Jurriz/VHF-Unit/README.md

# VHF-Unit
### Examensarbete Josef Lundberg, utfört åt followit.

Följande dokument är en projektplan för kursen X7006E, Examensarbete i Teknisk Fysik och Elektroteknik, Elektroteknik, Civilingenjör vid Luleå Tekniska Universitet. Arbetet kommer pågå i 20 veckor mellan januari till juni 2018. Målet är att ta fram en layout för ett kretskort på en ny produkt åt företaget Followit. Arbetet utförs av studenten Josef Lundberg. 

- Bakgrund: 

Företaget arbetar med trådlös kommunikation i form av olika former av spårningsutrustning. De använder olika typer av kommunikation däribland GPS, radio och GSM – teknik. Företaget håller på att utveckla en ny produkt som skall kommunicera med VHF teknik, vilket är samma frekvens som använd i radioapparater och till vissa Tv-kanaler. Denna typ av teknik använder redan företaget i andra produkter. Till denna produkt behöver företaget utveckla ett nytt kretskort, vilket detta projektarbete kommer handla om.  

- Utförande:  

Arbetet kommer handla om att ta fram en layout för detta system för en framtida produktion. Till projektet har företaget tagit fram de komponenter och delar som skall finnas med på kortet. Vikten kommer ligga på att genom noggranna studier kring kretskortstillverkning och i detta fall högfrekventa signaler på kortet göra ett kretskort som både fungerar som de skall och där inga störningar eller brus hämmar systemets funktion. Kretskortet kommer att vara mycket litet och strömsnålt. Nugranna studier skall göras innan för att på så sätt skapa en förståelse för den kod som skall köras på processorn och vidare kunna verifiera att alla delar och komponenter på kortet fungerar som tänkt. Varje komponent finns redan som utvecklingskort. Dessa kan inviduellt testas och verifieras med hjälp av en enklare typ av microkontrollen, typiskt en Arduino. 

Efter tillverkning skall kortet testas utförligt för att försäkra dess funktion. Vidare om tid finns kan en inkapsling till det kompletta systemet modelleras.

Detta examensarbete kommer att bidra till en större förståelse kring utformningen och designprocessen vid tillverkningen av ett integrerat system på ett kretskort. Samt att företaget i fråga kommer att få ett färdigt förslag på en layout som de sedan kan använda i sin produkt.  

Länk till min dagbok och all nyttig data på [OneNote!](https://onedrive.live.com/edit.aspx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)

#### En grov tidsplan över arbetet:
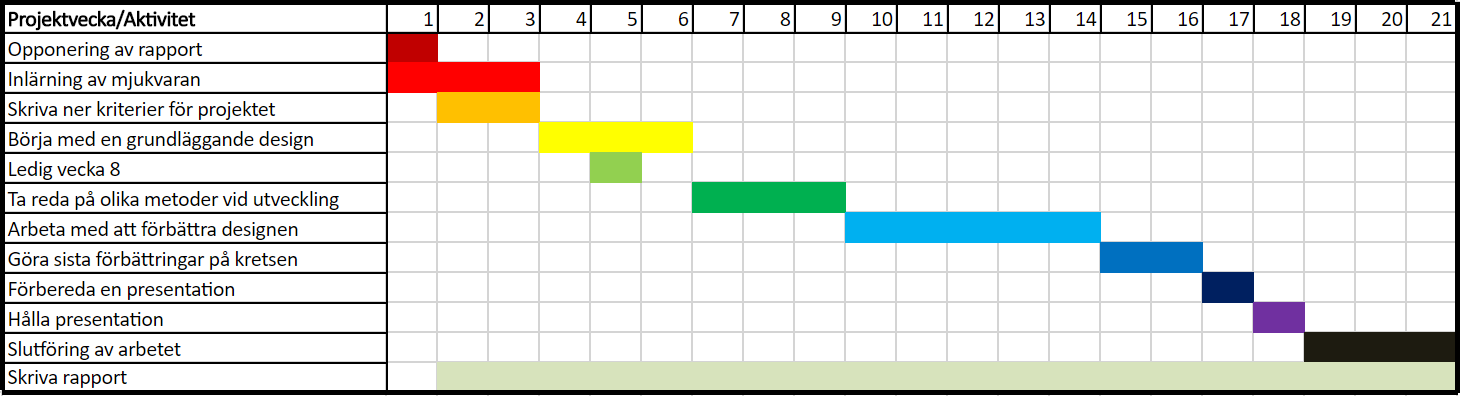
[picture p1: Tidsplan.png]
Tidsplan Josef
