Jurriz/VHF-Unit/Report/Gamla filer/Report LAtaex/Schematic.tex

\vspace{-10ex}%
\rule{\textwidth}{0.3pt}
\vspace{5ex}

To the \gls{pcb} a schematic over the complete system has to be constructed. This is built by noting all the connections that were determined in earlier chapter. The complete system is split up in to two different schematics, one describing the Radio components and the other shows the processor and all the other parts.
