Jurriz/VHF-Unit/Report/Gamla filer/Report LAtaex/method.tex

Hej detta är första dfelan av metoden

\section{schematics}
The idea that was presented to me was a half finished principle that i needed to understand and also expand with all the neccesary components that is not mentioned in this design.
