Jurriz/VHF-Unit/Report/main.pdf

Lule˚a University of Technology

Dept. of Computer Science, Electrical and

Space Engineering

# Master Thesis Engineering Physics and Electrical Engineering VHF-Unit

June 1, 2018

# Abstract

Surveillance and control have come a long way in the last years. Every new mobile phone, most cars, and smart watches have a Global Positioning System (GPS) tracing device built into it. Today it is hard to go anywhere without there being some sort of way of finding you. The art of finding has been around for a long time and one company that have taken the tracking aspect to the next step is Followit. For over 40 years they have built different types of satellite and radio transmitters to keep track of everything from small animals like hares and dogs to big elephants. They also got tracking solutions for vehicles like trucks and excavators.

i

# Preface

I would like to thank all the personal at Followit for taking me in and helping me through the project time. A special thanks to Bengt Evertsson for his help and all the good tips throughout the board layout development.
A big thanks goes to my supervisor Jonny Johansson at LTU for his support and guidance in the project.

Josef Lundberg
Lindesberg, June 1, 2018

ii

# Contents

Abbrevations | v
1 Introduction | 1
2 Theory | 5
3 Hardware | 9

iii

4 Software | 16
5 Results | 18
6 Schematics | 21
7 Discussion | 22
Appendices | 25
.2.1 | Bill of Materials: Main Printed Circuit Board (PCB) . . . | 27

iv

# Abbrevations

CAD Computer-aided design (CAD) is a computer system which aids the creation and modification of some kind of design. 15,

CLE CLass E (CLE, is a highly efficient switching amplifier type. 6

GPS The Global Positioning System (GPS) is a radionavigation system owned by the United States government and operated by the United States Air Force. It uses sattelites for geolocation and time. i

I

2C Inter-Integrated Circuit (I²C), is a serial computer bus. 3, 8

IC Integrated Circuit (IC) is a set of electronic circuits on one small flat chip. 1, 6, 7, 14

IMU Inertial Measurement Units (IMUs) are integrated circuits that can measure acceleration, rotational velocity and magnetic field strength. 10, 13

JTAG JTAG is an industry standard for verifying designs and testing printed circuit boards after manufacture. 16

LDO A low-dropout regulator is a DC linear voltage regulator that can regulate the output voltage even when the supply voltage is very close to the output voltage. 10, 19

LED A Light-emitting diode (LED), is a two-lead semiconductor light source. 3

MCU A Microcontroller Unit (MCU) is a single computer chip designed for embedded applications. 2, 7, 8, 10–12, 16, 20

PC Personal Computer (PC) is a multi-purpose computer whose size, capabilities, and price make it feasible for individual use. 20

PCB A Printed Circuit Board (PCB) is the common acronym when referring to populated circuit boards. iv, 1–3, 5, 6, 9, 15, 16, 21, 27

RF Radio Frequencies (RF) 6

v

RTC A Real time clock is an IC that is used to mesure time even when the main device is off. 10

SPI Serial Peripheral Interface 3, 7, 17, 20

ST STMicroelectronics 13, 23

TCXO Temperature Controlled Crystal Oscillator is an precise type of clock source which compensates for temperature differances. 12

TI Texas Instruments Inc. (TI) is an American technology company that designs and manufactures semiconductors and various integrated circuits. 23

UART Universal asynchronous receiver-transmitter 19, 20

VHF Very High Frequency (VHF) is the frequency band spanning all the frequencies from 30 to 300Mhz. 2, 14

VIA vertical interconnect access 9

vi

1

# Introduction

This chapter describes the idea behind and the background to this project. A rough sketch of how the work is divided and the goals for this project is provided.

## 1.1 Background

This is not a new area of products for Followit, different types of radio sending units have been made for over four decades now. With new and improved technology arriving each and every year new products ought to be made to have the latest most efficient and effective systems. Every generation of a component will most likely have a smaller physical size, have more advanced features and draw less power than the previous one. Followit wants to make a new unit which implements all the new and improved technologies into a small, advanced product with low power consumption. Customers have been asking for a simple, small and cheap radio unit from the company to complement their more advanced and powerful products. With this type of product, they could produce them in a larger number and gain new sale territories. By having such a small product it can be used in new areas that they never could before. The smaller the animal you want to track, the smaller equipment you could strap to them. This is one of the reasons that this product is so sought for in the business.
Most of the Integrated Circuit (IC)’s are already chosen by the company, but there are no actual implementations. The final version is supposed to work in different areas, both as a tracker for animals and also as a product for theft protection in cars and vehicles. This means that the design of the product needs versatility to work in all these different areas. Much consideration is taken to get the product both small and inexpensive. The cost of the PCB depends on the size, manufacturing and the numbers of layers. The rest of the cost comes down to the components, batteries, and casing.

1

Project VHF-Unit | June 1, 2018

## 1.2 Project goals

Followit wants to produce a Very High Frequency(VHF) radio unit which has a powerful Microcontroller Unit (MCU) for advanced programs and with some extra features that make it possible to use the finished product in different areas and with different types of characteristics. The project involves a first test prototype and a final version which is presented to the company as a finalized product ready for marketing and sales. To ensure proper functionality of the prototype a test program is written to the system to test the connection and functionality of all the components and accessibilities.
Both the cost of the bare board and the components need to be kept down. This requires some special attention to the board design, the manufacturing and component selection. There will be a study of the ways of making the product both small and cheap at the same time. The problem formulation will be considering making a prototype which is tiny but has a high manufacturing cost and an inexpensive that have a bigger physical size. The procedure of finding a good balance between the two is explained later in further detail.

## 1.3 Scope

The main focus of this thesis is to create a PCB prototype that is tested and well designed and works as intended. Some of the components in the product are predefined but their implementation has to be done. Extended test code is written to the product which includes tests for all the components in the circuit. The final PCB design will be delivered to the company for further programming and implementation. In case of time, a casing for the product as well as battery considerations will be made.

2 of 28

Project VHF-Unit | June 1, 2018

## 1.4 Approach

The idea that was presented to me was a half-finished principle that I needed to understand and also expand with all the necessary components that are not mentioned in this design. The initial work prior to this project can be seen in Figure 1. To get an understanding of all the parts and what there function are, a list is constructed for a simple overview of the system.

- MCU - For processing data and connecting all the periferals together to a complete system.
- Accelerometer - Used for measuring movements. Important for knowing how much the device is moving or if lying still.
- Radio - All the communication to and from the outside world is done using radio transmissions.
- RF switch - To switch between two low pass filter antennas from a single output.
- Real time Clock - The best way to keep an exact time, used for the system to keep track of the time even after one year of constant operation.
- Hall switch - To turn on and off the device, a solution that is already used by the company.
- Programmable buck converter - To alternate the supply voltage for the system.
- Logical inverter - To invert the signal for the programmable buck converter.
- LDO - Supply the radio oscillator.
- Miscellaneous components - Two Light-emitting diode (LED)’s, two oscillators, one for the processor and one for the radio module.

To get to the point of making the actual PCB a thorough analysis of the components and their connections need to be made. Firstly the datasheets are considered for an understanding of the component itself and the required connections for this particular implementation. Both power and data are crucial for operation and there might also be some peripherals connections and chip selection that needs to be considered.
By writing a program the functions of each individual component can be tested. The processor used in this project comes from the PIC18 family of 8-bit processors produced by Microchip Technologies. This processor is a fairly simple unit, which makes it a bit more challenging to program. It doesn’t have
a bunch of advanced libraries for example communication through Serial Peripheral Interface (SPI) or Inter-Integrated Circuit (I²C) like some other commonly used processors. The process will, therefore, involve some close to hardware programming. A more thorough description of the processor will be described later in this report. The code language used for this project is C.

## 1.5 Ethical and useability aspects

When designing a system meant for tracking and survaillence, one can think of the aspects of this. Tracking animals can be used by both the agricultuar and animal rising aswell as studies and wild animals. The radio unit can also

3 of 28

Project VHF-Unit | June 1, 2018

be attached to veichles or equipment. One aspect of a radio tracking device is that no special equipment or extra security is considered. If someone wants to track down the radio unit one can do so without problem, there is only the matter of finding the sending frequency and start searching. The unit is constructed for easy useabillity, with almost no ways of interagate with the product. Without buttons, interface or cables it is set up initially at the company to match all the customers criterias, scheme and functions directly out of the box. The only way of trancieving data to the unit is with the use of the radio. This is to possibly change the scheme, function and settings. This function is implemented in the hardware but possibly not used for this product until later in it’s lifecycle when the function is considered to be useful.

4 of 28

2

# Theory

This chapter will introduce the reader to the problem formulation and the underlying principles taken into account. The principle of radio communication and the important steps involved in developing a new product prototype will be presented. Basic information about the communication and programming will also be presented.

## 2.1 PCB

Good characteristics of the circuit the system will be produced on a four-layer PCB. This has a lot of advantages over a standard two-layer board. The four-layer design will have a top layer where all the components will be placed, a bottom layer with extra room for tracing tracks and having another ground polygon. The two inner layers consist of a power plane and a ground layer. Benefits of this are both easier connectability and also as a good way of making the circuit more resistant to high-frequency noise between the traces on the top and bottom layer.

## 2.2 Radio Frequency

Radio frequencies are a set of frequencies that are used for transceiving and receiving data wirelessly. Radio frequencies begin at one end of the spectrum where the frequencies are about 100Hz. It contains all the frequencies up to 300Ghz. Radio frequencies are divided into different bands, all with different characteristics and areas of implementation. A frequency spectrum is provided in Figure 2.1.

5

Project VHF-Unit | June 1, 2018

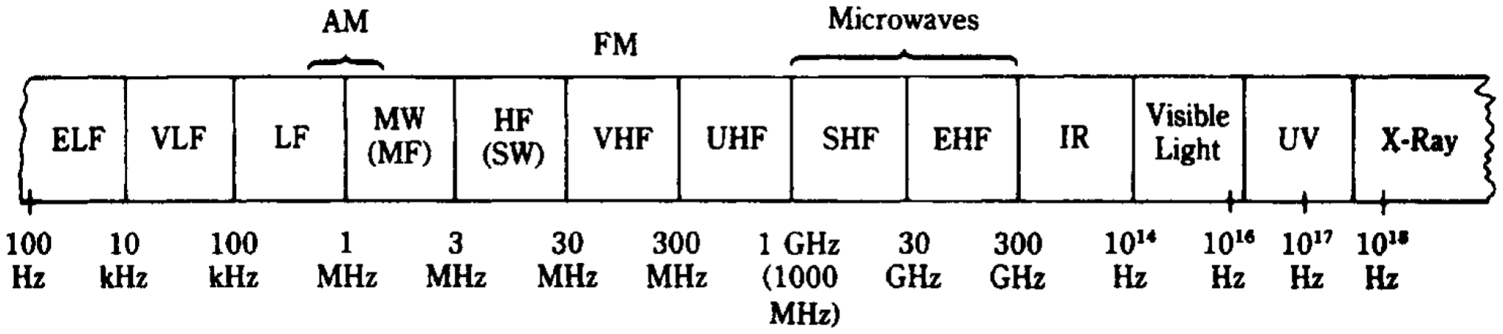
[picture p9: figure]

Figure 2.1: Electromagnitical frequencies Source: RF Circuit Design [? ]

## 2.3 Problems

Designing a circuit for radio transmission is an advanced and complex procedure. The high frequencies introduce a lot of interesting phenomena that need to be considered when constructing a circuit in these frequencies. When designing a circuit for Radio Frequencies (RF), components and traces on the PCB behaves in a different way and takes on different characteristics than an equal system at lower frequencies. Some of the challenges that arise are described in Secrets of RF Circuit Design [12]. Stray capacitance is one of the phenomena that arise when handling RF. Between conductors, conductors to ground and between components a small capacitance occurs when dealing with RF.
Another phenomenon that introduces is the so-called skin effect, where the ”skin” part comes from the physical phenomena that are happening. When the frequencies rise the resistance in a conductors core increases with it. As current choose the path of least resistance and will therefore in higher frequencies flow only on the outside most part of a component. A visual explanation of this can be seen in ??.
The output signal from the radio transceiver is matched at 50 ohms and this has to be matched with the output stage components. These components commonly is a network of inductors and capacitors. This matching network is described later in this section. From different types of radio signal transceiver, the type used in this case is determined by the radio IC’s manufacturer. [4]

### 2.3.1 Class E amplifier

The CLass E (CLE) amplifier type used here uses switching type of amplification to increase efficiency and reduce power loss. The most interesting part of CLE is the fact that up to ideal power efficiency can be achieved by constructing this type. [15]

### 2.3.2 Chebychev Filter

The Chebyshev type of filter is special in the fact that it has a steep fall rate and a high Q. The Q factor is commonly used in filter design as a function of the length of the stopband through the whole passband. This makes it very suited for radio designs.

6 of 28

Project VHF-Unit | June 1, 2018

### 2.3.3 Radio antenna filter

Stating in the datasheet to the radio IC the rough design aspects are defined. The Chebyshev filter is recommended for this radio for its good characteristics. With a high Q value the steeper the slope is in the stop-band region.

## 2.4 SPI

SPI communication is used to communicate between the MCU and other IC’s on a circuit board.SPI uses four wires to communicate and additional one wire for each extra IC that is connected. The transmission works in a synchronous serial manner where each bit is sent one at the time synchronous to a supplied clock signal. Different types of SPI connections exist but with the most common being the four-wire serial bus. Here SCL, SDO, SDI, and SS is used. [2]

- SCL - Serial CLock, a clock is supplied to synchronize the data transmissions.
- SDO - Serial Data Out, Data is sent from this port.
- SDI - Serial Data In, Data is transmitted to this port.
- SS - Slave Select, Selects a device for communication.

Eight bits are sent together to form a package of one byte. Four different modes are available when communicating through SPI. These modes determine which type of clock signal provided and how the data is sampled in the devices. Two different types of clock-signal, one where the clock is pulled high when idle and the other one pulled low when idle. This is often called in the registers as; CPOL. The other mode selects the timing of data bits relative to the clock signal. Data is sampled either when the clock signal goes high or in the middle of a clock pulse. CPHA is the often the name of this selection. This concludes the different modes. A visual explanation of SPI communication is provided in Figure 2.2.

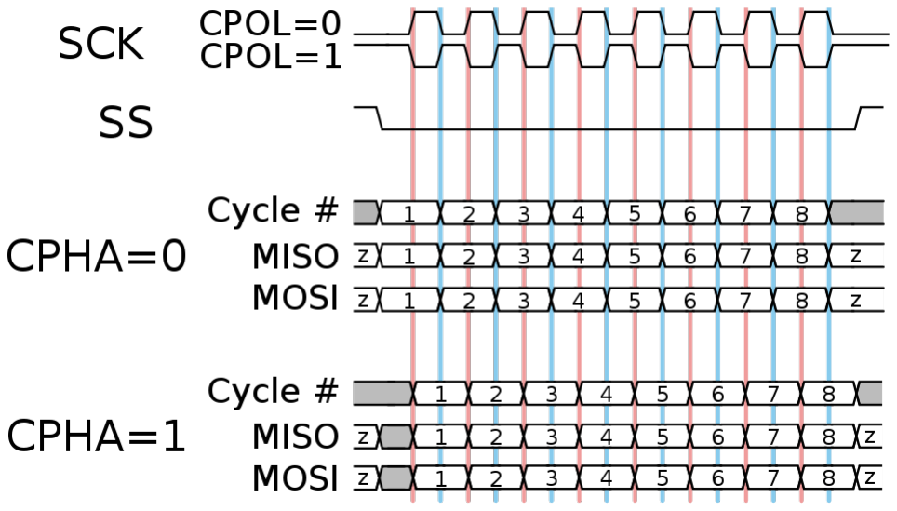
[picture p10: figure]

Figure 2.2: Timing and modes for a transmission over SPI Source:
https://commons.wikimedia.org/wiki/File:SPI_timing_diagram.svg

7 of 28

Project VHF-Unit | June 1, 2018

The interface uses one master device and multiple slaves. The master device handles the communication and supplies the selection of slaves. To enable a connection and choose which slave is used an individual slave select must be present. When set, only the chosen slave device is able to communicate. From the MCU’s datasheet the following diagram show in Figure 2.3 how the connection works when connection several slave devices.

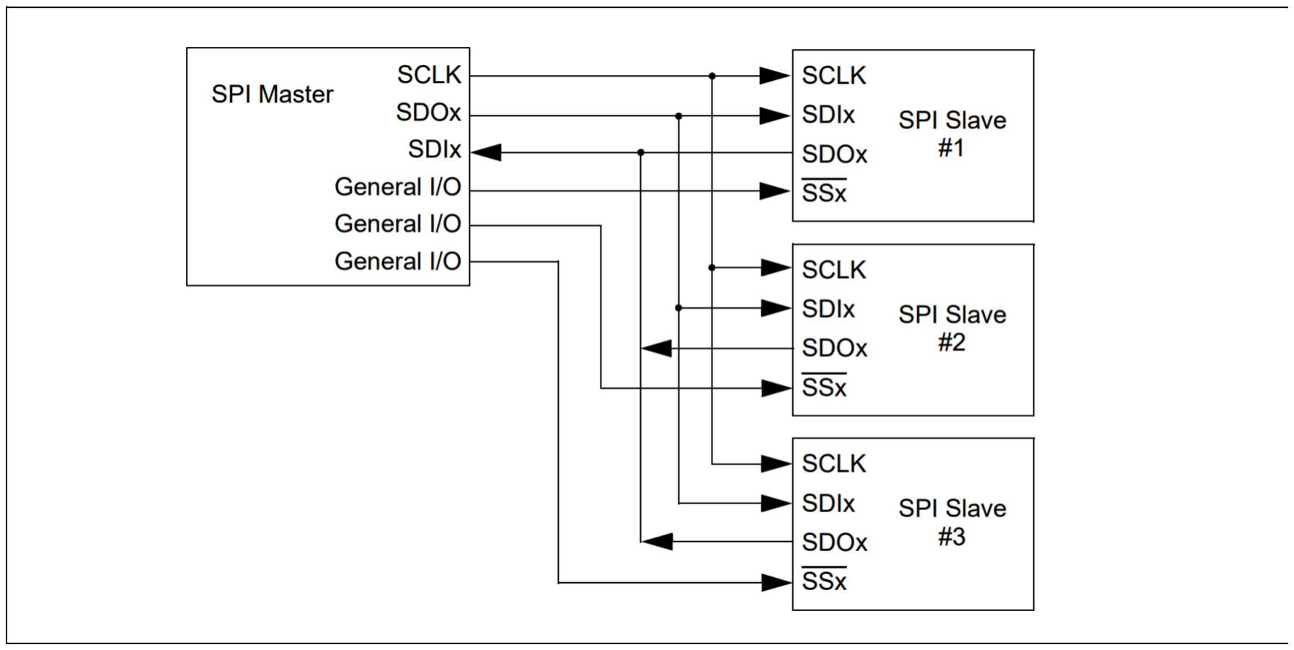
[picture p11: figure]

Figure 2.3: SPI master and multiple slave connections Source:
http://ww1.microchip.com/downloads/en/DeviceDoc/40001412G.pdf

Data is sent out from the MCU at the SDO wire and at the other end connected to the SDI pin of a receiving device.

## 2.5 I

2C

A more advanced type of communication is I

2C. I

2C is more often used in
larger circuits or when the distances are longer. The I

2C interface uses pullup resistors to set the idle state of the signals high. Different speeds require different types of resistors, with the higher resistors not able to handle faster transfer speeds but draw less power when transmitting data.

8 of 28

3

# Hardware

From the objects described briefly in earlier chapters a complete system is constructed. A deeper look into each component with some information of their functionality and implementation will be presented in this chapter. Why some specific components are chosen is also answered here.

## 3.1 Layout parameters

When starting the layout some initial rules need to be set up. These parameters are set by the board manufacturer. The design can be produced at different places but when ordering from this manufacturer the constraints that are used is the same parameters that the supplier uses as their standard. These rules and constraints may differ from one supplier to another but as the company already uses this supplier the same will be used for this project. Naturally, for this project, the minimum spaces and distances that does not make for a supplement charge are chosen as the design rules. A list of these parameters can be seen below.

- Trace width: minimum of 6 mils (0,1524mm)
- Vertical Interconnect Access diameter: 10 mils
- Maximium thickness of board

### 3.1.1 Landgrid

Each component on a PCB have their own landgrid design, which corresponds to the components contact pads. These pads are copper pads on the PCB which is left open and separated from the solder resist material covering the rest of the PCB to hold the component and the solder. Often are the pads a bit larger then the acctual contact point of the component to accomendate some additional solder and making the soldering process as easy and troublefree as possible. One simple landgrid design used in this report is the 0402 package size for passive components, the design can be seen in ??.

9

Project VHF-Unit | June 1, 2018

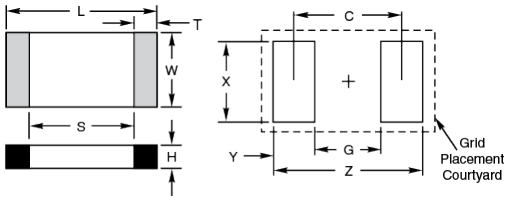
[picture p12: figure]

Figure 3.1: The prototype connection Source: Aurthor

Some of the design aspects used are described earlier and here they will be described in more detail. The industry standard is always good to aim for, in this case, the basic designs are taken from IPC’s design guidline[? ]. While these are made for optimal manufacturability the footprints used on the test board are modified to enable for easier solderability, production and rework if needed. The landgrids are made slightly bigger and longer to achieve this. The downside of making the pads larger is that each component takes up more real estate and the final board size increases.

### 3.1.2 Easy prototyping

The components that are going to be used in high frequency often come in tiny packages. The best components used in this area of work will be small to fit in small modern advanced systems like mobilephones and. This gives the protypability problems with easy ability to solder and use, To make a

## 3.2 Structure

The product is constructed with a number of components, which all have a central role in the final product. They can all be seen in Figure 3.2. A list of the major components and their function can be seen below:

- MCU: The central part of an integrated system, handles all the calculations and the program code.
- Radio: All the communications with the rest of the world will be handled by the radio, sending on the VHF and UHF band.
- Inertial Measurement Unit (IMU): Movement detection is measured with an accelerometer, this to determine if the unit is in motion or lying still.
- Low-dropout regulator (LDO): A Low-dropout regulator can supply the system with a smoother voltage because no switching is taking place.
- Hall sensor: The hall sensor is used as a switch for the system by sensing if a magnet is nearby and then turning off the circuit.
- Real time clock (RTC): A real-time clock is important to acquire data at a specific set time. It is important that the clock is exact over the whole life of the product.

10 of 28

Project VHF-Unit | June 1, 2018

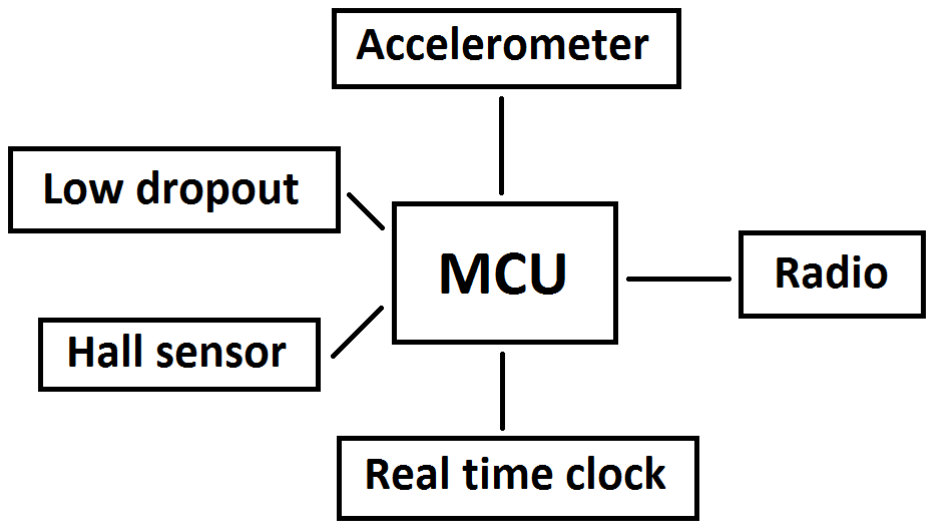
[picture p13: figure]

Figure 3.2: The prototype connection Source: Aurthor

Each of the components of this project is carefully chosen to get the functionality and effect that the company is after. To ensure the system works as intended the company has acquired development boards to each of the components. Every component needs to be tested to ensure their individual functionality. Each development board is connected to the microcontrollers board. First off, the MCU have to be set up in a correct way with all its parameters and then the other components could be connected and initialized one after another. The whole connection can be seen.

## 3.3 Micro Controller Unit

Every advanced system needs a central processing unit to make all the calculations needed. Why a lot of systems needs some powerful processor this system wich is a bit easier with The power consumption is higly dependent on the speed of which the processor is runnig, the faster the more power it consumes and also the slower the less current it will draw. And by the MCU beeing the component with the single higest power consumption the speed is set to a speed as low as possible. This low speed is not a concern in this particular system when the operations required is not time or speed sensitive. The voltage supplied to the MCU is another parameter that will alter the power consumption. The comonent is a low power model which can handle a lower source voltage. A voltage between 1.7 to 3.6 is required, anything lower will not start the device and anything higer will damage the the part. To get the right speed of a crystal we need to get the right product for this particular case. Many different types of oscillators exists, both internal and external types. The MCU used for this project is a processor type that is used by this company many times before and has been chosen to this project for its small size, low power draw, sufficient connections, and features. The particular processor used is the PIC18LF46K22[3]. The version used is one with 40 pins. All the connections available are shown in Figure 3.3.

11 of 28

Project VHF-Unit | June 1, 2018


Figure 3.3: PIC18LF46K22 pinout Source:
http://ww1.microchip.com/downloads/en/DeviceDoc/40001412G.pdf

### 3.3.1 Power

Powering it is done by connecting the VDD pins to the power net. Connected to the ground is the Vss pins on the processor. To ensure the current fed is as smooth as possible capacitors are connected between these two pins. The value of these capacitors is chosen to 100nF.

### 3.3.2 Oscillator

To operate the MCU a clock signal is mandatory, this can be implemented in different ways. Either with the internal High, Medium and Low-frequency oscillator or an external one. Where the external rely on a specific circuitry to provide the clock source. Examples of external oscillators are clock modules, quartz crystal resonators or ceramic resonators and resistor-capacitor circuits. When a circuit is specified to be power efficient the speed of the clock plays a central role. As this product is specified to run on a small battery the speed of the system is kept low to increase the lifetime of the battery. The clock signal is generated from an external Temperature Controlled Crystal Oscillator (TCXO).

## 3.4 IMU

12 of 28

Project VHF-Unit | June 1, 2018

## 3.5 Accelerometer

The motions of the system are measured with an IMU system. This system can be used in a lot of different cases, both to detect if the unit is stationary or moving or if there are very hard and fast movements in the product. One of the simplest IMU’s is the 3-axis accelerometer, it detects accelerations in three axes, x, y, and z. The component used is a 3-axis, ultra-low-power and high-performance accelerometer from STMicroelectronics (ST) [5]. The component is the simplest of IMU’s that this manufacturer has and this simplicity makes for a product that is only incorporate one single function. 3-axis accelerometer means that it can measure

### 3.5.1 Power

Two voltage connections are apparent on this device, one which is called VDD and the other is called VDD-IO. The VDD is the supply voltage and VDD-IO determines the logic voltage level.

### 3.5.2 Connenctions

13 of 28

Project VHF-Unit | June 1, 2018

## 3.6 Radio component

The radio module used in this project is from the company Silabs. The chosen radio IC have the characteristics that are wanted in this type of product. The radio transmission used is the earlier explained class E. With this pice the class E is already implemented in the radio as this is widely used today and a very effective radio signal. The type of filter used for sending radio signals at VHF frequencies is defined in the defined

### 3.6.1 Power

### 3.6.2 Connenctions

In the registers

14 of 28

Project VHF-Unit | June 1, 2018

### 3.6.3 Solidworks PCB

Followit uses the PCB board design software Solidworks PCB from DAS-SAULT SYSTEMES. It utilizes the industry-proven Altium design engine ` for layout and routing of printed circuit boards and combined with a close connection with the mechanical Computer-aided design (CAD) of classical Solidworks. With this program, the PCB layout and design can be transferred seamlessly over to the mechanical environment to create an exact case or enclosure for the circuit board. The version used in this thesis is (Update 2.0).

## 3.7 Power consumption

The total power consumption is calculated by adding the current draw from each individual component together. A different test is conducted to try different modes of the system. One describing the power consumption of only the processor. This is done by running it in an infinite loop with all the other components at the circuit powered down or in power down mode. Since the system is not supposed to be active just a small time with a longer power down mode in between the power consumption on the system has to account for a longer time span. The tests are made with a standard scheme used already by the company. The scheme consists of a small radio pulse every second and the system being inactive in between these radio pulses.

15 of 28

4

# Software

What is the step after the PCB is produced? It is time to test the system, and this is done with the help of a test program. This chapter will guide the reader through this process of setting up the processor to run program code. How all the components are programmed and tested will be explained in this chapter.

## 4.1 Programming

In the start of every embedded system, the processor have to be programmed. Here the most common implementation is the Joint Test Action Group (JTAG), where the all the programming and debugging is done through a standardized interface. The approach is different on this MCU, here three pins are used
to program the device. The first one is the ”PGC”, which is the clock signal for the In-Circuit Debugger and ”PGD”, In-Circuit Serial Programming. The third pin needed from the processor is the MCLR. These pins on the processor have to be accessible to program the microcontroller.

## 4.2 Software implementation

The processor does not start up on it own, much consideration needs in making right initialization and configure it right. A source voltage is supplied to the processor to get it to operate. There are some initial registers that need to be set in order to initialize and start the processor. This varies between different processors and models and is different for applications and systems. These registers contain information about the speed of the processor.

## 4.3 Radio implementation

Radio Chip Waking Up First, the radio is in the off state. After the SDN pulled low, wakes up and performs a Power on. maximum of 6 ms (900 µ s room temperature) ready to receive commands on the SPI bus. The GPIO1 pin goes high when the radio is ready for receiving SPI commands. During the reset period, the radio cannot accept any SPI commands.

16

Project VHF-Unit | June 1, 2018

### 4.3.1 Accelerometer implementation

The accelerometer communicates with SPI, this requires three wires that has to be considered in the code.

## 4.4 PC software

The foundation for every development is a good development environment, both as the circuit boards are created and the software implementations needed later in the process.

### 4.4.1 MPLAB

Microchip which is the producer of the MCU used in this project has their own development environment which holds a lot of handy features when making a program for their products.

### 4.4.2 Assembly

The actual code that runs on this processor is assembly, the most common hardware code which is used in almost all types of MicroController units. Assembly is a hardware type language which means that describes the actual process for the In the early days of computing, programming in Assembler was used to program almost any type of computer. These days, however, it is pretty much the preserve of embedded designers, particularly when using smaller 8-bit devices. [16]

### 4.4.3 C18

The C program is compiled with the compiler C18. This is the compiler which has been the official compiler for this particular processor. This compiler is used for all the processors in the family PIC18. This compiler is some years old and lacks some modern features. The version used in this project is (3.47)?

17 of 28

5

# Results

This chapter will guide the reader through the whole process of developing a system prototype. Designing the PCB, soldering the components, troubleshooting the board and writing the necessary code are some of the steps involved and they will all be described in detail here.

## 5.1 Schematics

The schematics over the circuit is created by placing all the components discussed earlier, every IC have a small number of components that are placed in a way so that it is easy to understand which components belong to which. A title is added to every part in the design for a good overview of the system. Since the section which included the radio is large it is placed on a separate page. When additional components are added in additional pages can be inserted. These schematics can be found in ??.

## 5.2 Layout

### 5.2.1 First design

The first of two boards is 3.5 times 3.5 mm in size. The different parts of the circuit are laid out in a way that it is easy to inspect and resolder if necessary. The main components of the board are placed close to each other at one side to get an idea of the design for the final product. This board is equipped with some test points for easy connections with test probes and oscilloscope. The silkscreen print on the top of the board was vague at some places and made distinguish them from each other hard. The pin one location at one part could not be spotted. A view of the board can be seen in ??.

18

Project VHF-Unit | June 1, 2018

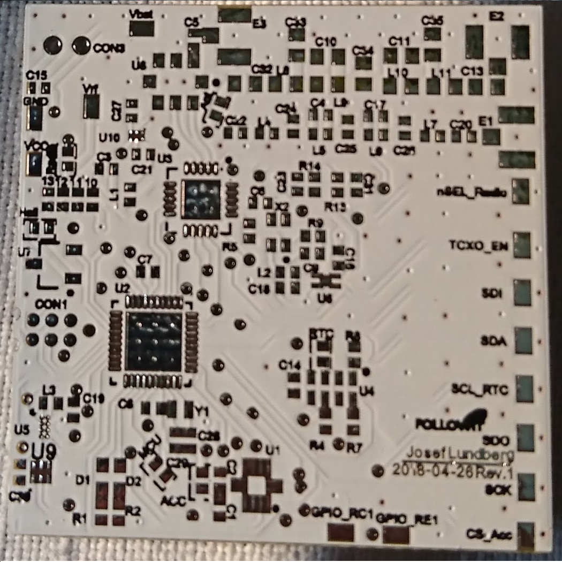
[picture p14: figure]

Figure 5.1: First (1) revision circuit board. Source: Author

## 5.3 Communication

### 5.3.1 UART

The Universal asynchronous receiver-transmitter (UART) connection interfered with another connection which leads to one function not working as intended. The function that is the enabling line to the LDO which powers the oscillator for the radio. It is fixed by connection one of the extra pins that was laid out beforehand directly to the LDO. The transmitting half of the UART connection is working as intended on this version, some of the resulting data which is sent to the computer can be seen in Figure 5.2.

19 of 28

Project VHF-Unit | June 1, 2018

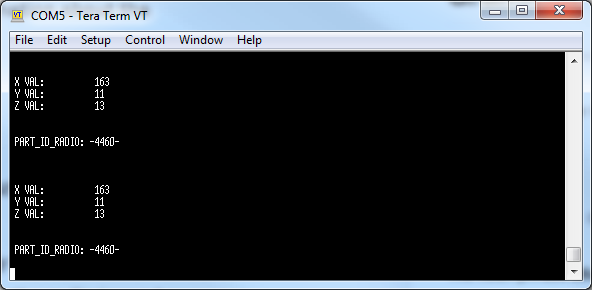
[picture p15: figure]

Figure 5.2: Simple UART transmission to a Personal Computer (PC) Source: Aurthor

### 5.3.2 SPI

Testing started with both theMCU, radio and accelerometer soldered to the board. No communications were achieved when both of these slave devices were connected at the same time. After some troubleshooting, the failing factor of this is the accelerometer having it’s SPI connection the other way around. The data out (SDO) line was connected to the data output, and the SDI was connected to the data input line of the accelerometer.

## 5.4 improvements

From the first version some valuable point can be determined, both for the layout, schematics, and wiring.

20 of 28

6

# Schematics

To the PCB a schematic over the complete system has to be constructed. This is built by noting all the connections that were determined in earlier chapter. The complete system is split up in to two different schematics, one describing the Radio components and the other shows the processor and all the other parts.

21

7

# Discussion

The prototype could have been made directly using a company to place all the components, or the components should have been mounted with a pic and place machine to eliminate some initial troubleshooting and hassle regarding the SMT process. But with one of the project’s goals to keep down the process looked like this. This did, however, increase the understanding and personal expertise in the area.
The test points were a good addition, they were frequently used and employees at the company did find them interesting for further use in future projects. Additional test points would be a good idea. When the board already had real estate to hold some additional points it should have been implemented. The hardest bit with the system was the voltage adjusting buck converter. Both the fact that it was one of the smallest pieces which made it hard to solder. Also the fact that it needed some adjustments in the form of
Designing a PCB with white solder mask looks great and with black silkscreen, it was easy to see every marking. Problems did occur though, when visually inspecting the traces on the PCB it was hard almost impossible to see. There is a reason that green is the most common choice. (The final design was therefore created with green solder mask)
To ease troubleshooting more a via could be placed in every single transmission line, this to be able to read the voltage levels and data at every trace. When building the first revision only some of the traces.

22

# Bibliography

[1] Class E RF Amplifier Theory of Operation http://www.classeradio.com/theory.htm. (http://www.classeradio.com/theory.htm)
[2] Overview and Use of the PICmicro Serial Peripheral Interface http://ww1.microchip.com/downloads/en/devicedoc/spi.pdf.
[3] PIC18LF46k22, Micro controller unit from Microship http://ww1.microchip.com/downloads/en/DeviceDoc/40001412G.pdf (http://ww1.microchip.com/downloads/en/DeviceDoc/40001412G.pdf)
[4] Si4460, class E radio module from Silicon Labs https://www.silabs.com/documents/public/data-sheets/Si4463-61-60-C.pdf. (https://www.silabs.com/documents/public/data-sheets/Si4463-61-60-C.pdf)
[5] LIS2DW12, 3-axis accelerometer from ST http://www.st.com/content/ccc/resource/technical/document/datasheet/group3/30/3a/4e/6b/68/16/4a/35/DM00323179/files/DM00323179.pdf/jcr:content/translations/en.DM0032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 (http://www.st.com/content/ccc/resource/technical/document/datasheet/group3/30/3a/4e/6b/68/16/4a/35/DM00323179/files/DM00323179.pdf/jcr:content/translations/en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)
[6] IQXT-350, Temperature controlled crystal oscillator from IQD https: //www.mouser.se/datasheet/2/741/iqxt-350-1-33-1075257.pdf.
[7] ABS05, Tuning fork Crystal from Abracon https://abracon.com/Resonators/ABS05.pdf. (https://abracon.com/Resonators/ABS05.pdf)
[8] RV-8803-C7, Real Time clock from Micro Crystral http://www.classeradio.com/theory.htm.
[9] TPS62743, Voltage selecting buck converter from Texas Instruments Inc. (TI) http://www.ti.com/lit/ds/symlink/tps62743.pdf.
[10] TLV717P, Low-Dropout Regulator from TI http://www.ti.com/lit/ds/symlink/tlv717p.pdf. (http://www.ti.com/lit/ds/symlink/tlv717p.pdf)
[11] TLV717P, Low-Dropout Regulator from TI http://www.ti.com/lit/ds/symlink/tlv717p.pdf. (http://www.ti.com/lit/ds/symlink/tlv717p.pdf)
[12] Joseph J. Carr, Secrets of RF Circuit Design, McGraw-Hill/Tab Electronic, 2000
[13] Howard Johnson and Martin Graham, High Speed Digital Design: A Handbook of Black Magic, Prentice Hall, 1993

23

Project VHF-Unit | June 1, 2018
[14] Chris Bowick, RF Circuit Design, Newnes, 2007
[15] NATHAN O. SOKAL AND ALAN D. SOKAL. Class E - A New Class of High-Efficiency Tuned Single-Ended Switching Power Amplifiers, IEEE Journal of Solid-State Circuits, Volume: 10, Issue: 3, Jun 1975
[16] Timothy Wilmshurst, Designing Embedded Systems with PIC Microcontrollers - Principles and Applications, Elsevier Ltd, 2007

24 of 28

# Appendices

25

Project VHF-Unit | June 1, 2018
.1 | Large Figures

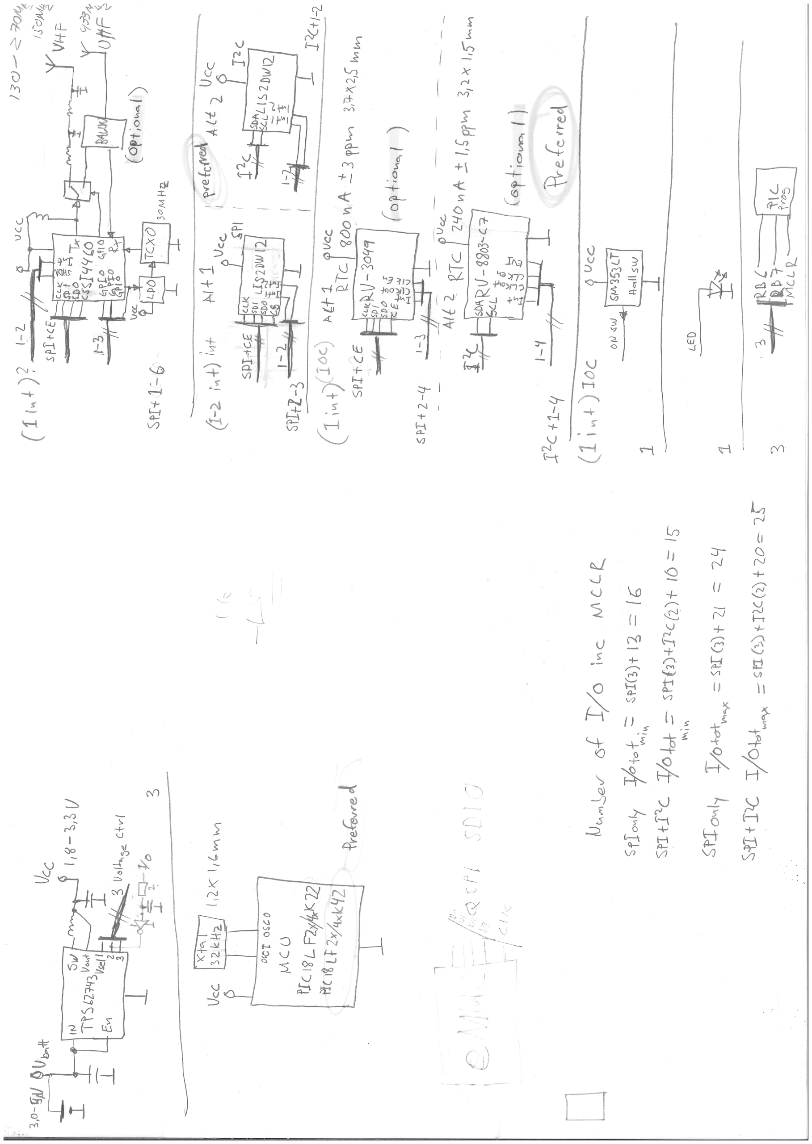
[picture p16: figure]

Figure 1: The initial schematics made by Followit Source: Aurthor

26 of 28

Project VHF-Unit | June 1, 2018
.2 | Lists
.2.1 | Bill of Materials: Main PCB

27 of 28

Project VHF-Unit | June 1, 2018

The project; complete with all software code, the application, hardware files and more, can be found online in the github-repo: https://github.com/Jurriz/VHF-Unit

28 of 28

Project VHF-Unit | June 1, 2018

29 of 28
