Jurriz/VHF-Unit/Report/Gamla filer/Report LAtaex/Figures/Anders_schema.pdf

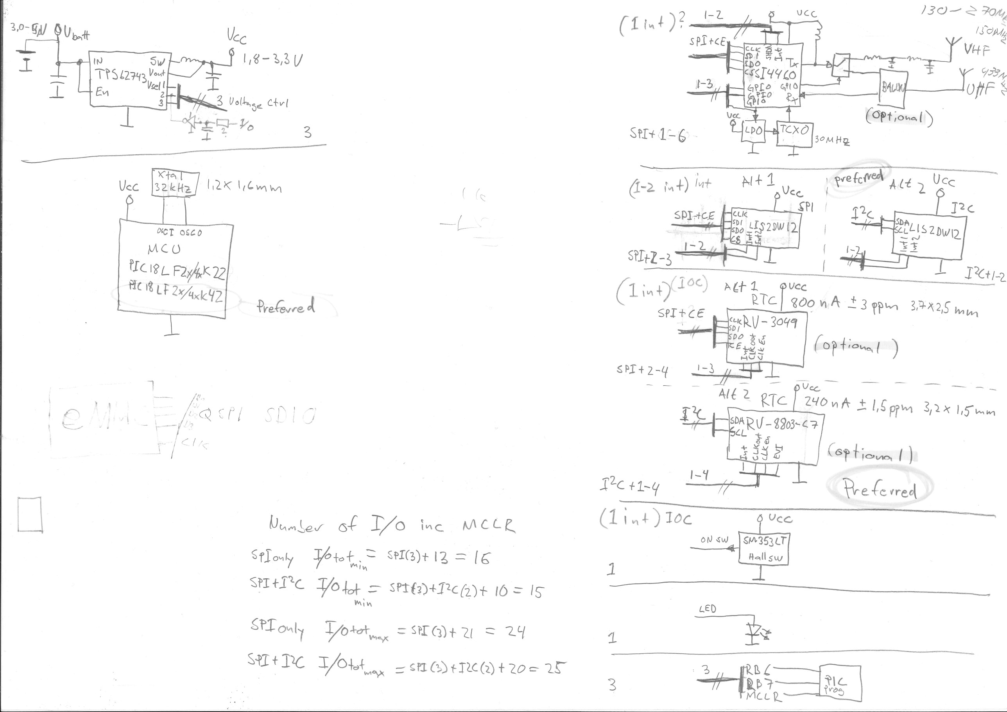
[picture p17: page 1]
