Jurriz/VHF-Unit/Report/Gamla filer/Report LAtaex/Figures/Anders_schema_rot.pdf

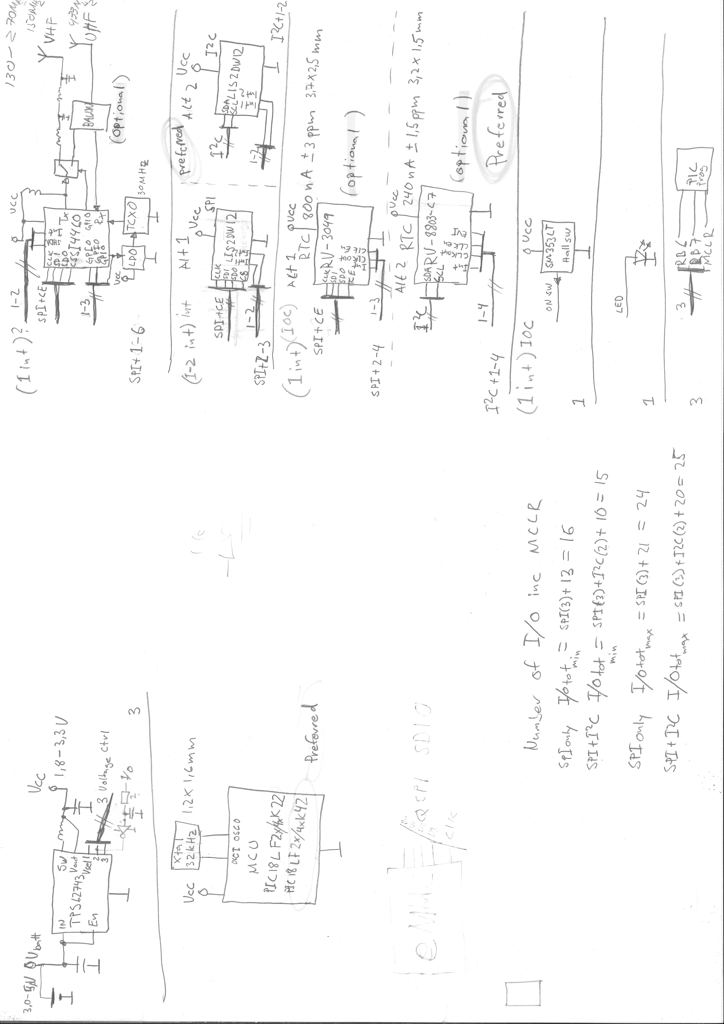
[picture p18: page 1]
