Jurriz/VHF-Unit/Övrigt/Anmälan till presentation Josef Lundberg.pdf

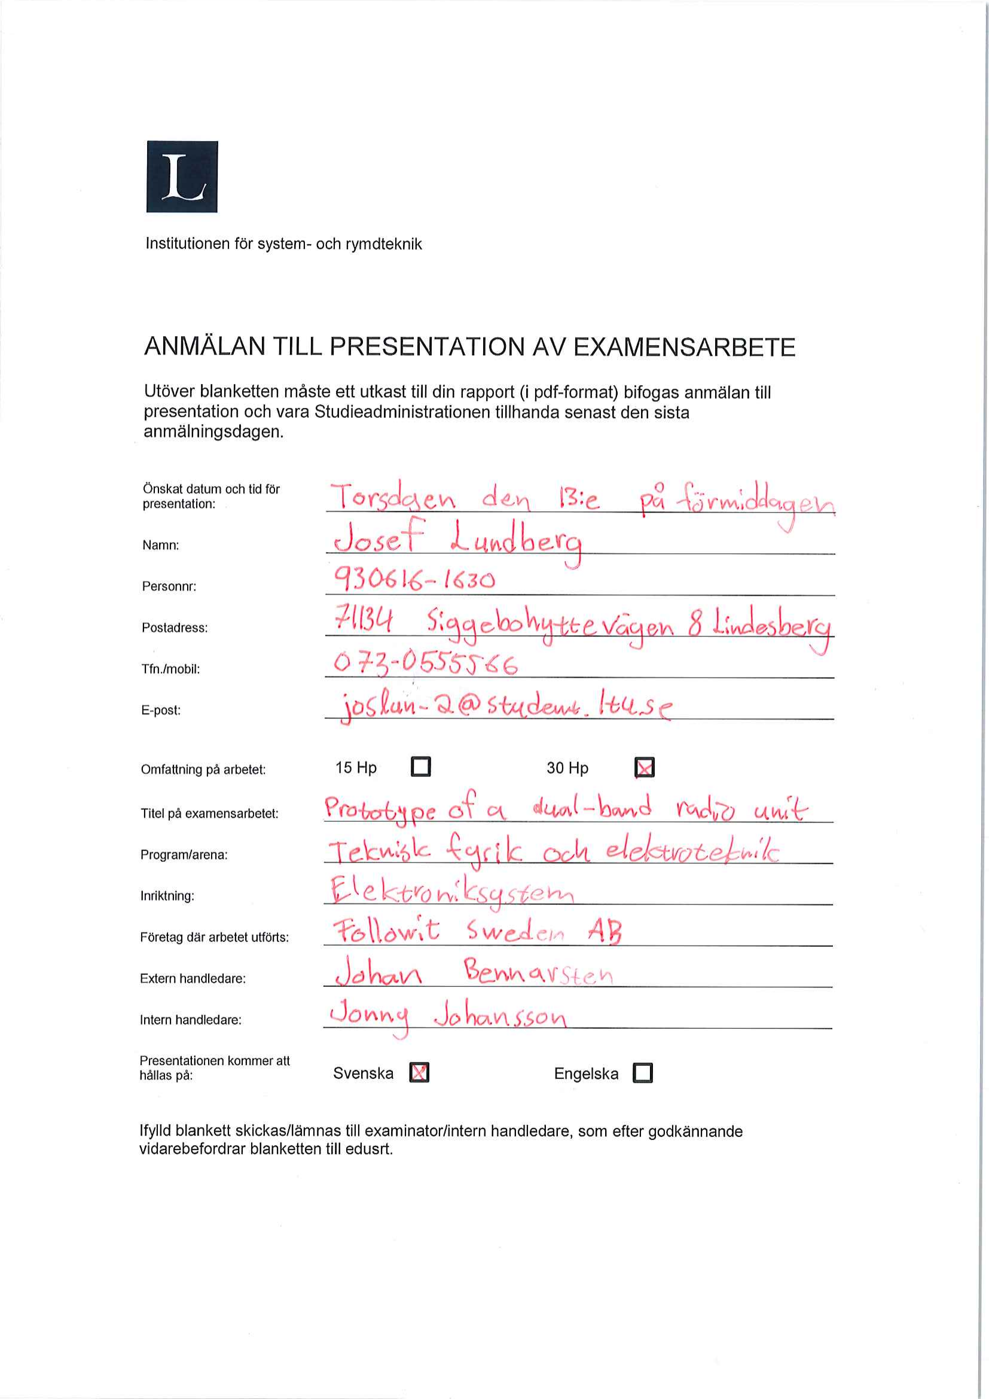
[picture p19: page 1]
