Jurriz/VHF-Unit/Kretskortet/175px-WEEE_symbol_vectors.svg.png

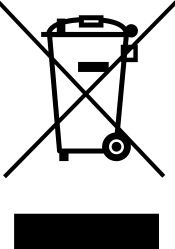
Kretskortet/175px-WEEE_symbol_vectors.svg.png
