Jurriz/VHF-Unit/peekypokey/wiki/downloadWiki/docs/Automated water filling system_diode.PNG

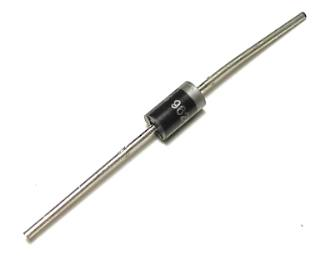
peekypokey/wiki/downloadWiki/docs/Automated water filling system_diode.PNG
