Jurriz/VHF-Unit/peekypokey/wiki/downloadWiki/docs/Automated water filling system_diode_close.PNG

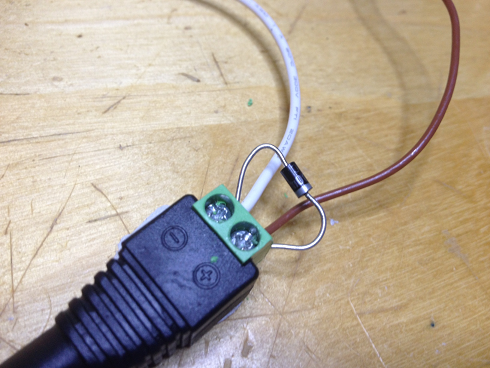
peekypokey/wiki/downloadWiki/docs/Automated water filling system_diode_close.PNG
