Jurriz/VHF-Unit/peekypokey/wiki/downloadWiki/docs/Automated water filling system_sensor.JPG

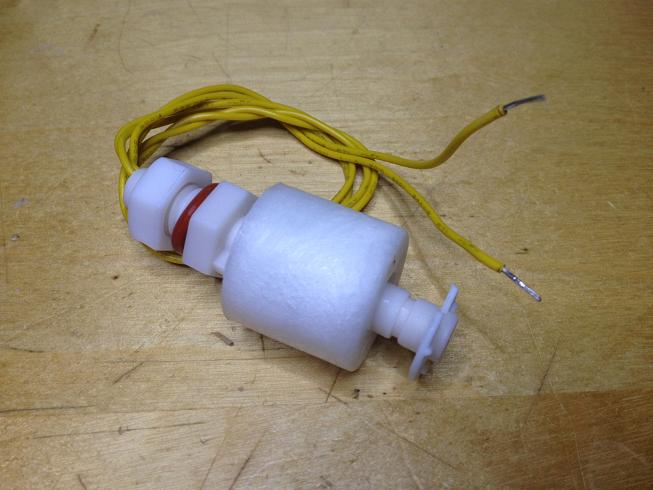
peekypokey/wiki/downloadWiki/docs/Automated water filling system_sensor.JPG
