Jurriz/VHF-Unit/peekypokey/wiki/downloadWiki/docs/Automated water filling system_valve.JPG

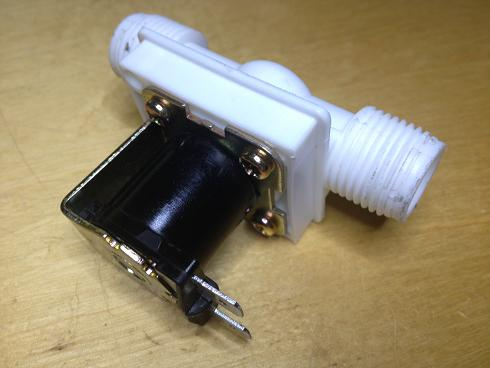
peekypokey/wiki/downloadWiki/docs/Automated water filling system_valve.JPG
