Jurriz/VHF-Unit/peekypokey/wiki/downloadWiki/docs/Controlling a relay_form.JPG

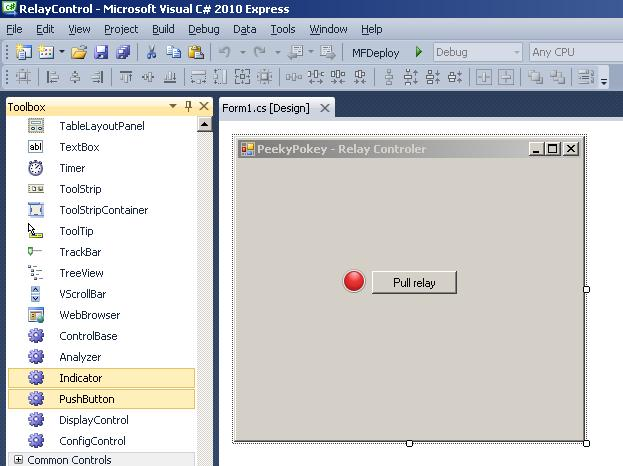
peekypokey/wiki/downloadWiki/docs/Controlling a relay_form.JPG
