Jurriz/VHF-Unit/peekypokey/wiki/downloadWiki/docs/Controlling a relay_props2.JPG

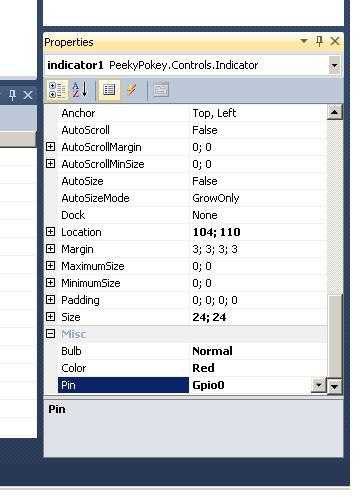
peekypokey/wiki/downloadWiki/docs/Controlling a relay_props2.JPG
