Jurriz/VHF-Unit/peekypokey/wiki/downloadWiki/docs/Controlling a relay_props.JPG

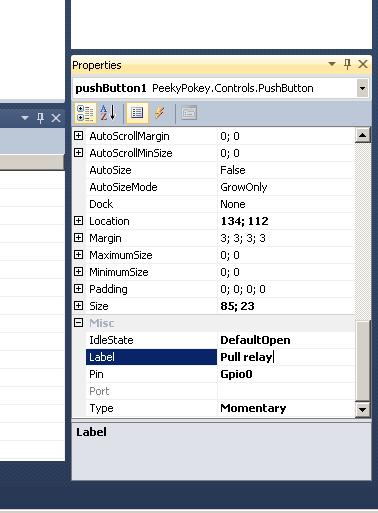
peekypokey/wiki/downloadWiki/docs/Controlling a relay_props.JPG
