Jurriz/VHF-Unit/peekypokey/wiki/downloadWiki/docs/Controlling a relay_relay.JPG

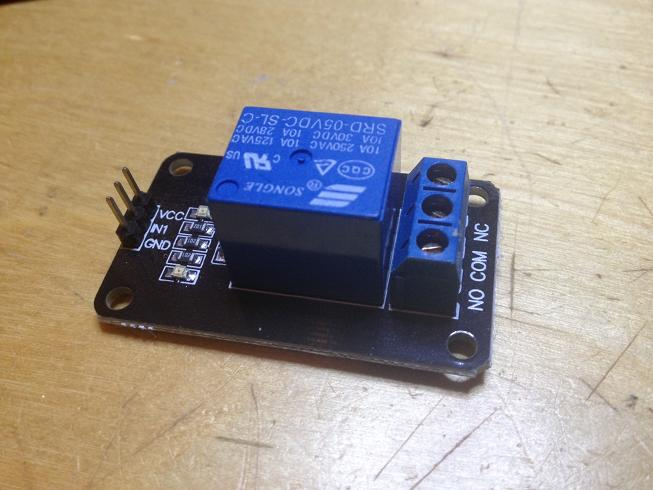
peekypokey/wiki/downloadWiki/docs/Controlling a relay_relay.JPG
