Jurriz/VHF-Unit/peekypokey/wiki/downloadWiki/docs/Controlling a relay_runapp.JPG

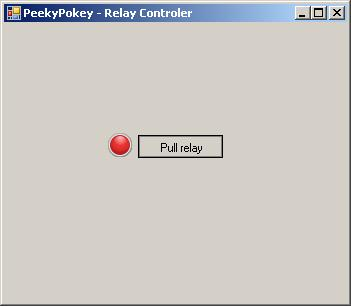
peekypokey/wiki/downloadWiki/docs/Controlling a relay_runapp.JPG
