Jurriz/VHF-Unit/peekypokey/wiki/downloadWiki/docs/Home_Blockdiagram.PNG

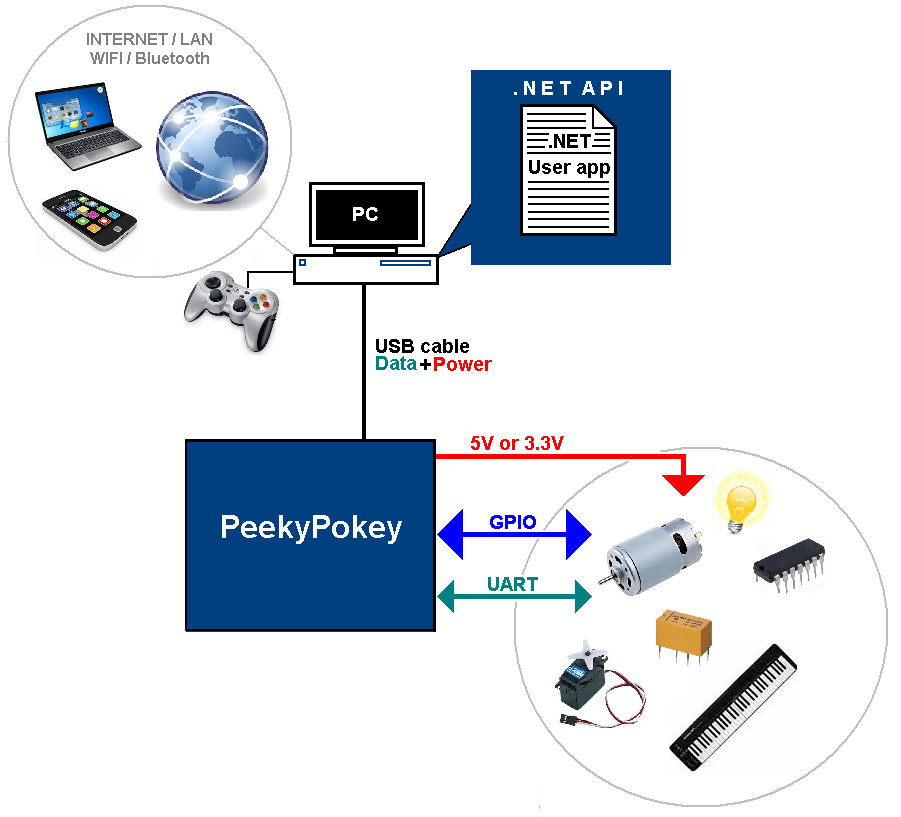
peekypokey/wiki/downloadWiki/docs/Home_Blockdiagram.PNG
