Jurriz/VHF-Unit/peekypokey/wiki/downloadWiki/docs/Home_peekypokey-figure-v2-clean.png

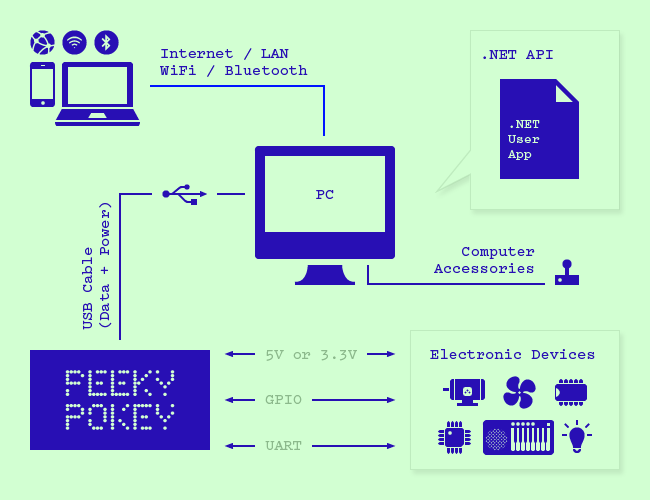
peekypokey/wiki/downloadWiki/docs/Home_peekypokey-figure-v2-clean.png
