Jurriz/VHF-Unit/peekypokey/wiki/downloadWiki/docs/Home_pp221.PNG

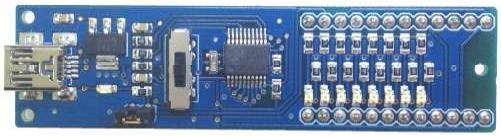
peekypokey/wiki/downloadWiki/docs/Home_pp221.PNG
