Jurriz/VHF-Unit/peekypokey/wiki/downloadWiki/docs/HomeAutomation_433trx.jpeg

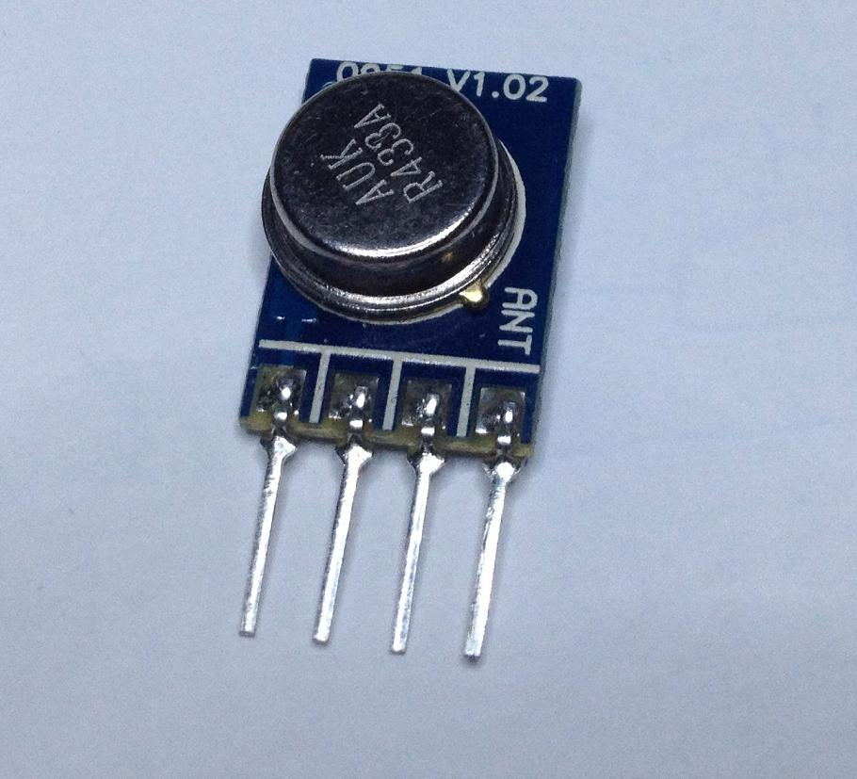
peekypokey/wiki/downloadWiki/docs/HomeAutomation_433trx.jpeg
