Jurriz/VHF-Unit/peekypokey/wiki/downloadWiki/docs/HomeAutomation_app.PNG

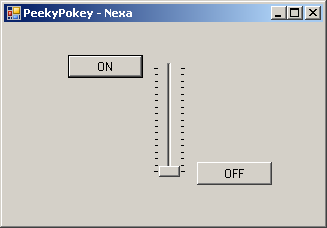
peekypokey/wiki/downloadWiki/docs/HomeAutomation_app.PNG
