Jurriz/VHF-Unit/peekypokey/wiki/downloadWiki/docs/HomeAutomation_mote.jpg

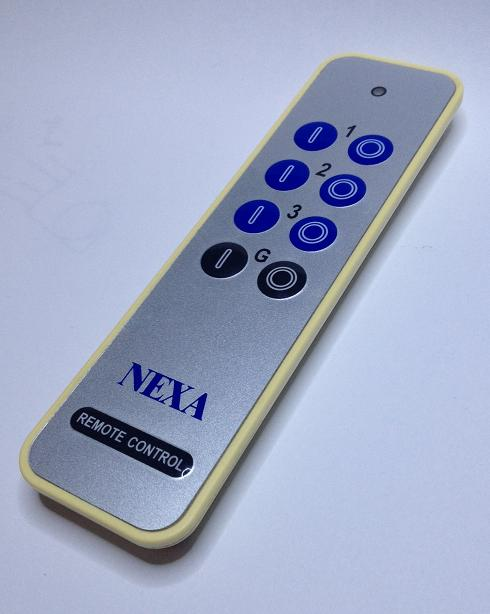
peekypokey/wiki/downloadWiki/docs/HomeAutomation_mote.jpg
