Jurriz/VHF-Unit/peekypokey/wiki/downloadWiki/docs/HomeAutomation_outlets.jpeg

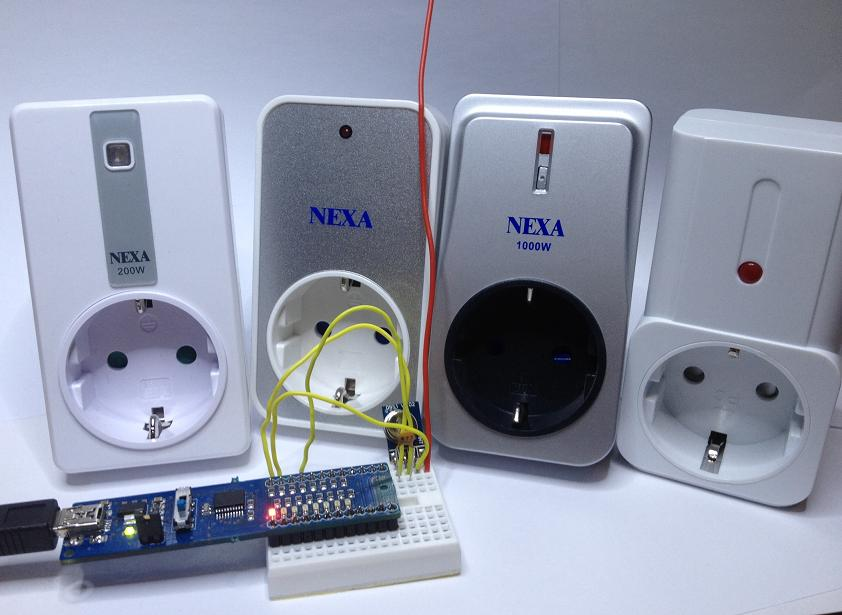
peekypokey/wiki/downloadWiki/docs/HomeAutomation_outlets.jpeg
