Jurriz/VHF-Unit/peekypokey/wiki/downloadWiki/docs/HomeAutomation_ppdashboard.PNG

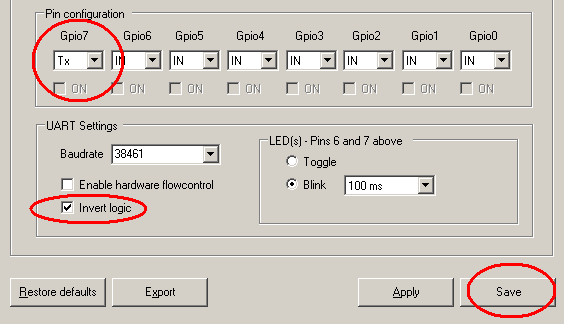
peekypokey/wiki/downloadWiki/docs/HomeAutomation_ppdashboard.PNG
