Jurriz/VHF-Unit/peekypokey/wiki/downloadWiki/docs/HomeAutomation_pptrx.JPG

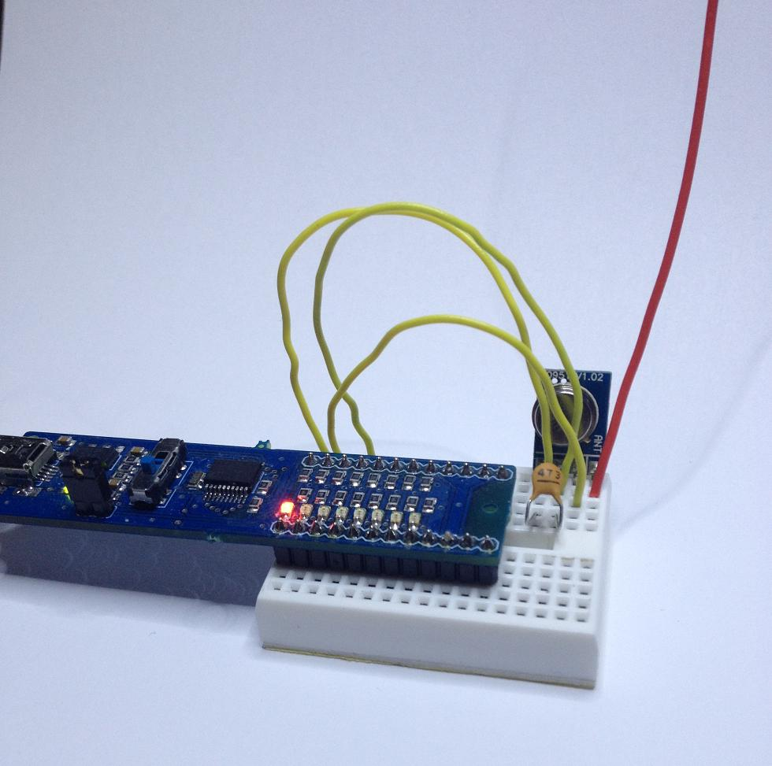
peekypokey/wiki/downloadWiki/docs/HomeAutomation_pptrx.JPG
