Jurriz/VHF-Unit/peekypokey/wiki/downloadWiki/docs/MFRC522_appwindow.PNG

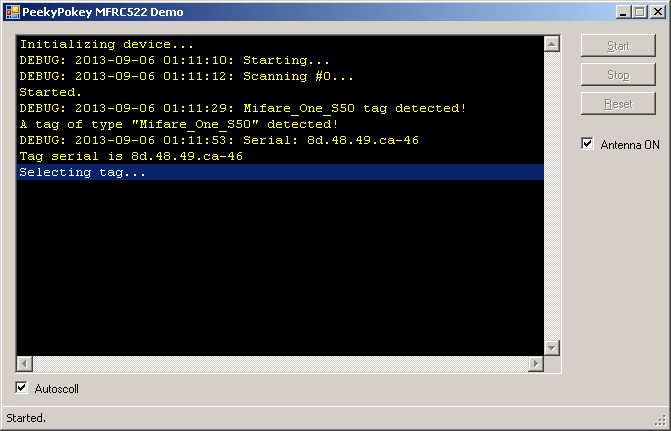
peekypokey/wiki/downloadWiki/docs/MFRC522_appwindow.PNG
