Jurriz/VHF-Unit/peekypokey/wiki/downloadWiki/docs/MFRC522_reader.JPG

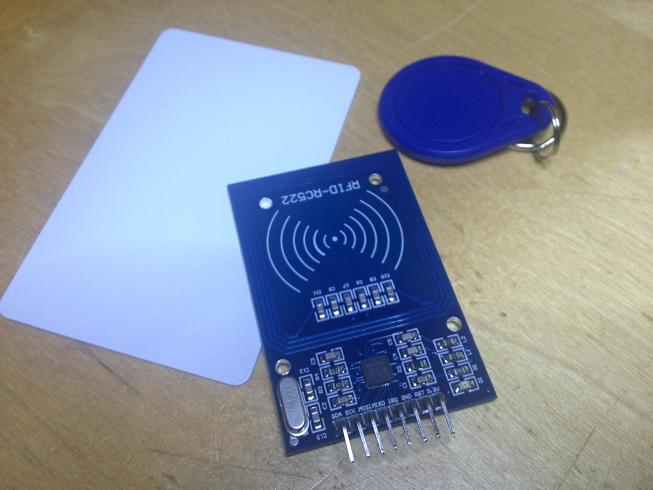
peekypokey/wiki/downloadWiki/docs/MFRC522_reader.JPG
