Jurriz/VHF-Unit/peekypokey/wiki/downloadWiki/docs/Pin-out_peekypokey_pinout.PNG

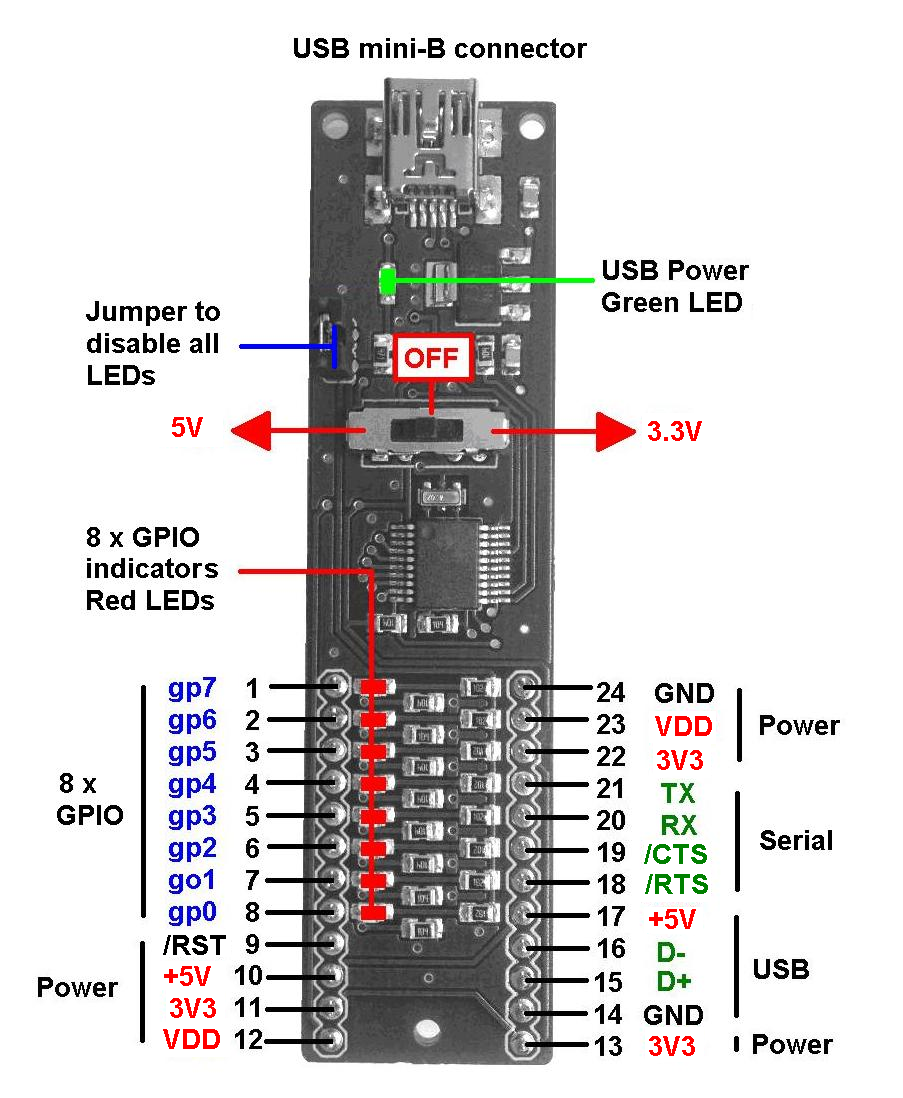
peekypokey/wiki/downloadWiki/docs/Pin-out_peekypokey_pinout.PNG
