Jurriz/VHF-Unit/peekypokey/wiki/downloadWiki/docs/PIRexample_pir_back.JPG

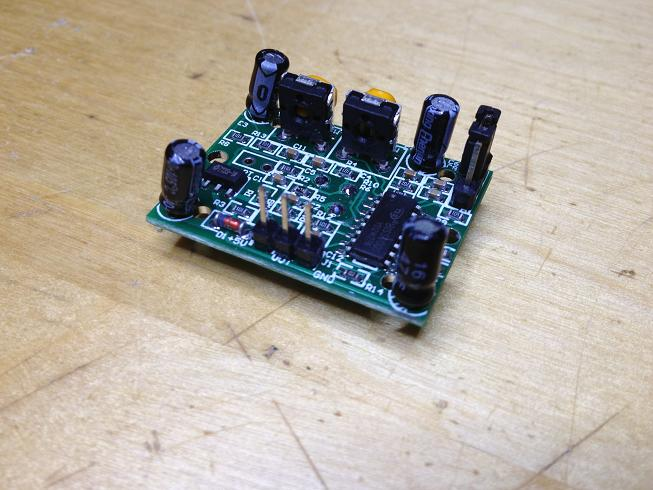
peekypokey/wiki/downloadWiki/docs/PIRexample_pir_back.JPG
