Jurriz/VHF-Unit/peekypokey/wiki/downloadWiki/docs/PIRexample_pir_front.JPG

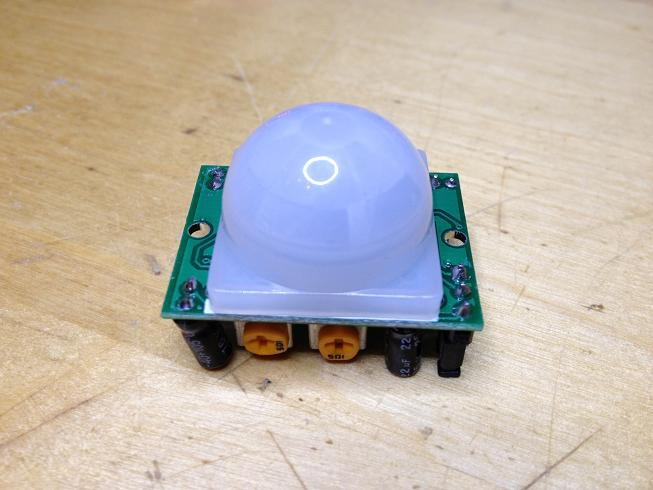
peekypokey/wiki/downloadWiki/docs/PIRexample_pir_front.JPG
