Jurriz/VHF-Unit/peekypokey/wiki/downloadWiki/docs/Projects_blinky.JPG

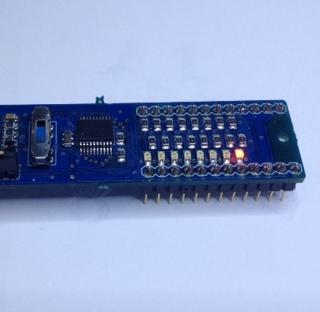
peekypokey/wiki/downloadWiki/docs/Projects_blinky.JPG
