Jurriz/VHF-Unit/peekypokey/wiki/downloadWiki/docs/Reading a 4 by 4 keypad_4x4-keypad_small.JPG

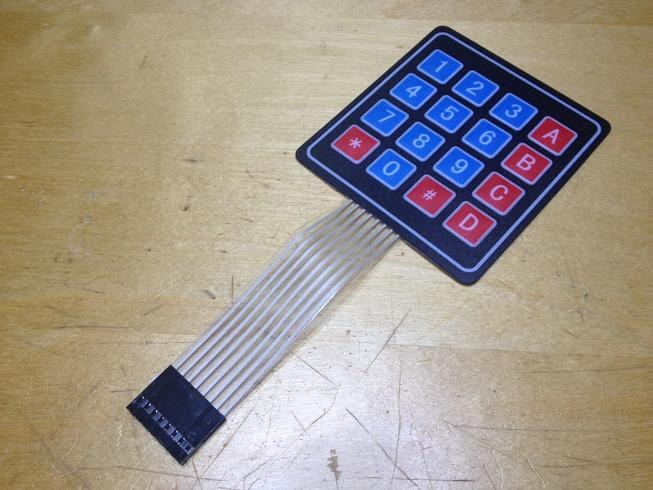
peekypokey/wiki/downloadWiki/docs/Reading a 4 by 4 keypad_4x4-keypad_small.JPG
