Jurriz/VHF-Unit/peekypokey/wiki/downloadWiki/docs/Reading a 4 by 4 keypad_switch_matrix.JPG

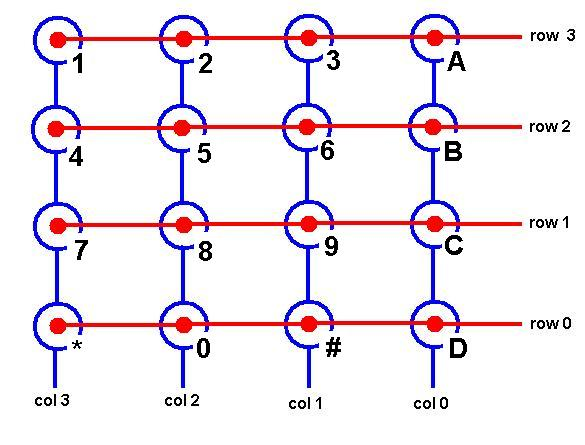
peekypokey/wiki/downloadWiki/docs/Reading a 4 by 4 keypad_switch_matrix.JPG
