Jurriz/VHF-Unit/peekypokey/wiki/downloadWiki/docs/RotaryVolume_analyzer.PNG

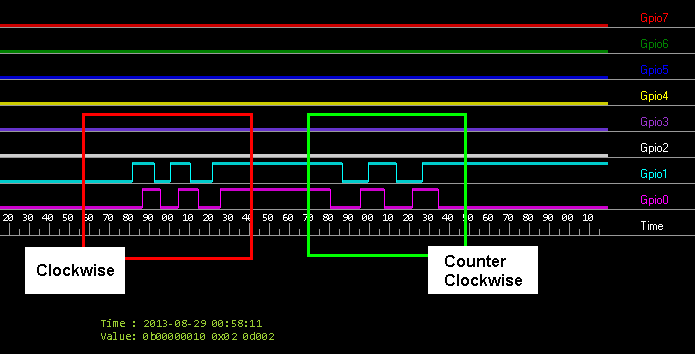
peekypokey/wiki/downloadWiki/docs/RotaryVolume_analyzer.PNG
