Jurriz/VHF-Unit/peekypokey/wiki/downloadWiki/docs/RotaryVolume_breadboard.JPG

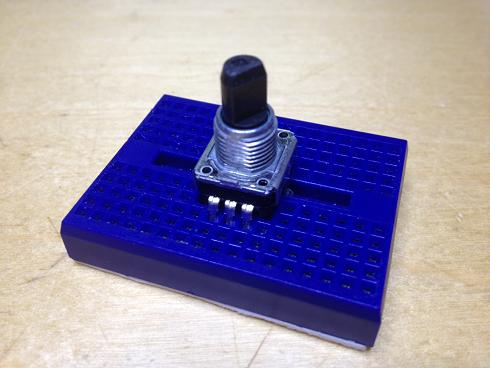
peekypokey/wiki/downloadWiki/docs/RotaryVolume_breadboard.JPG
