Jurriz/VHF-Unit/peekypokey/wiki/downloadWiki/docs/RotaryVolume_encoder.JPG

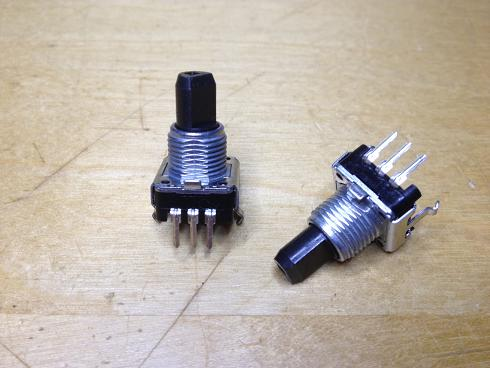
peekypokey/wiki/downloadWiki/docs/RotaryVolume_encoder.JPG
