Jurriz/VHF-Unit/peekypokey/wiki/downloadWiki/docs/RotaryVolume_mastervol.PNG

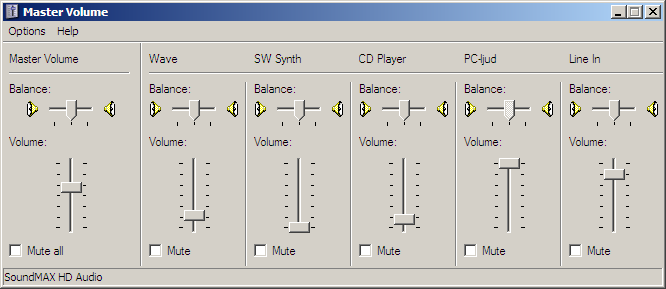
peekypokey/wiki/downloadWiki/docs/RotaryVolume_mastervol.PNG
