Jurriz/VHF-Unit/peekypokey/wiki/downloadWiki/docs/RotaryVolume_pinconfig.PNG

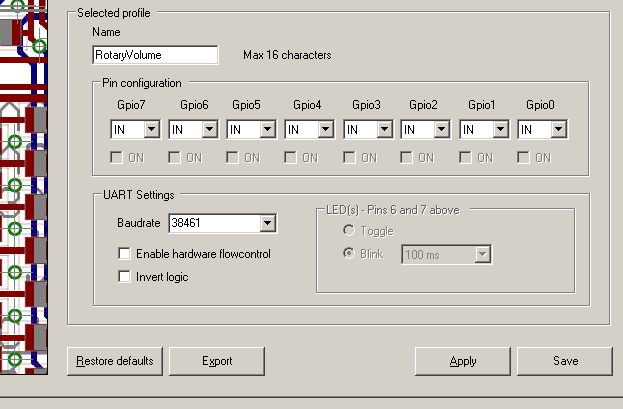
peekypokey/wiki/downloadWiki/docs/RotaryVolume_pinconfig.PNG
