Jurriz/VHF-Unit/peekypokey/wiki/downloadWiki/docs/Screenshots_display.JPG

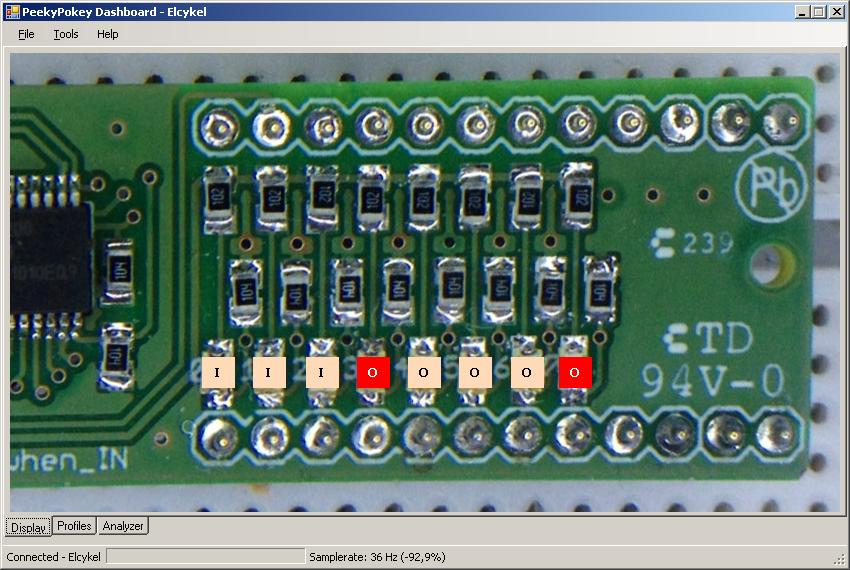
peekypokey/wiki/downloadWiki/docs/Screenshots_display.JPG
