Jurriz/VHF-Unit/peekypokey/wiki/downloadWiki/docs/Screenshots_logics.JPG

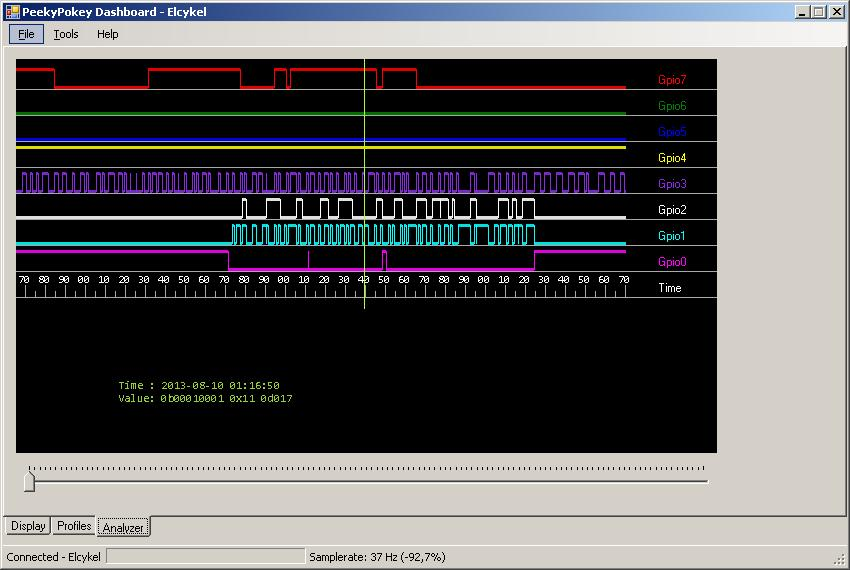
peekypokey/wiki/downloadWiki/docs/Screenshots_logics.JPG
