Jurriz/VHF-Unit/peekypokey/wiki/downloadWiki/docs/Screenshots_profiles.JPG

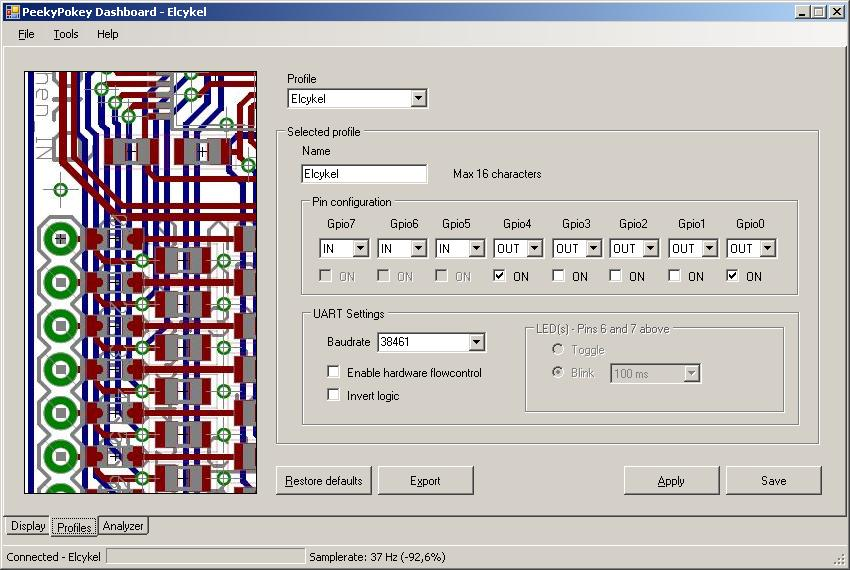
peekypokey/wiki/downloadWiki/docs/Screenshots_profiles.JPG
