Jurriz/VHF-Unit/Report/Figures/ACC_SPI.PNG

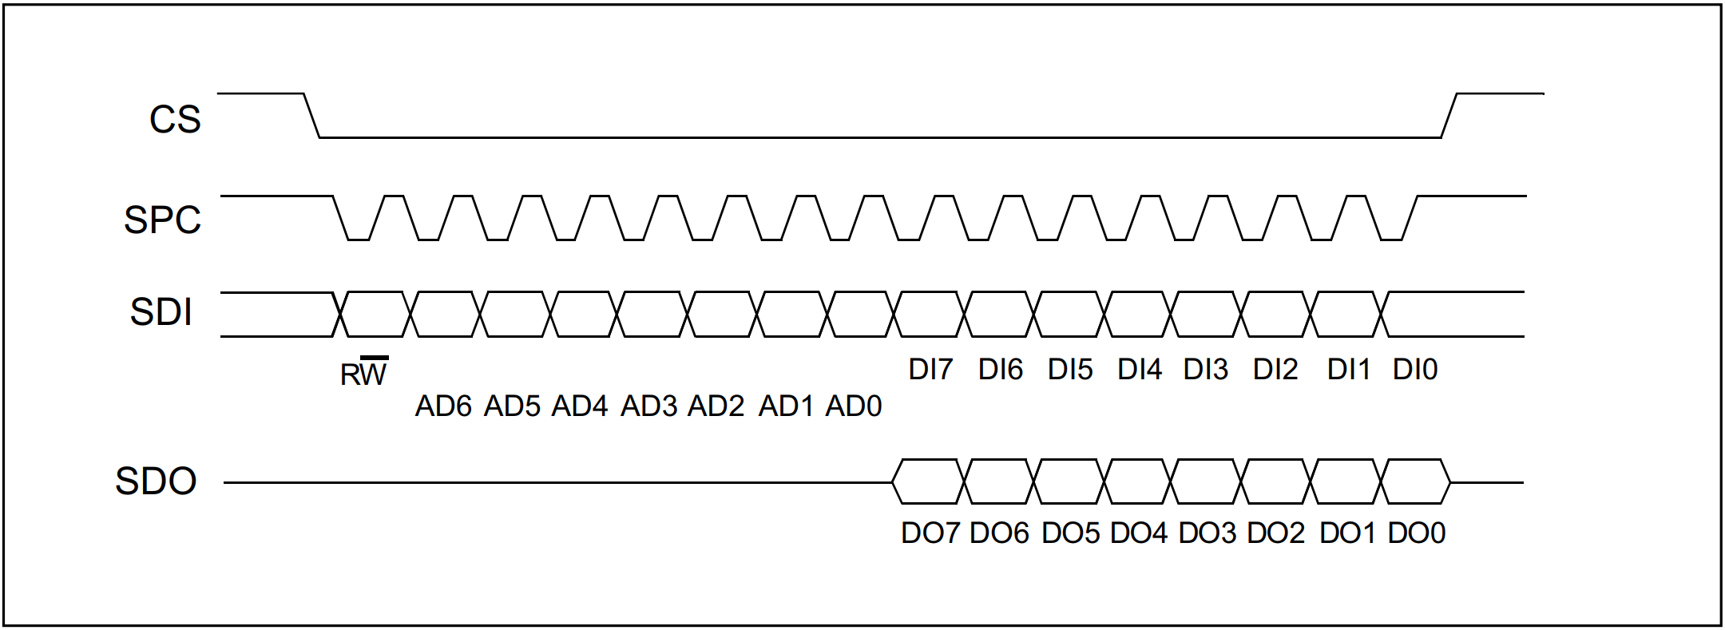
Report/Figures/ACC_SPI.PNG
