Jurriz/VHF-Unit/Report/Figures/Anders_kopplign.PNG

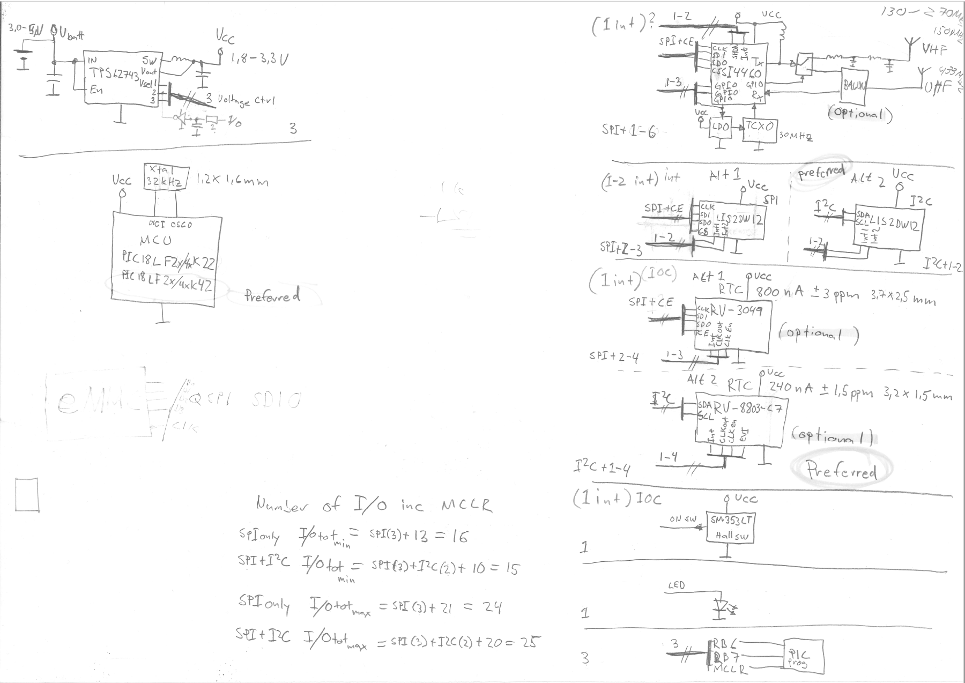
Report/Figures/Anders_kopplign.PNG
