Jurriz/VHF-Unit/Report/Figures/Buck converter Vsel.PNG

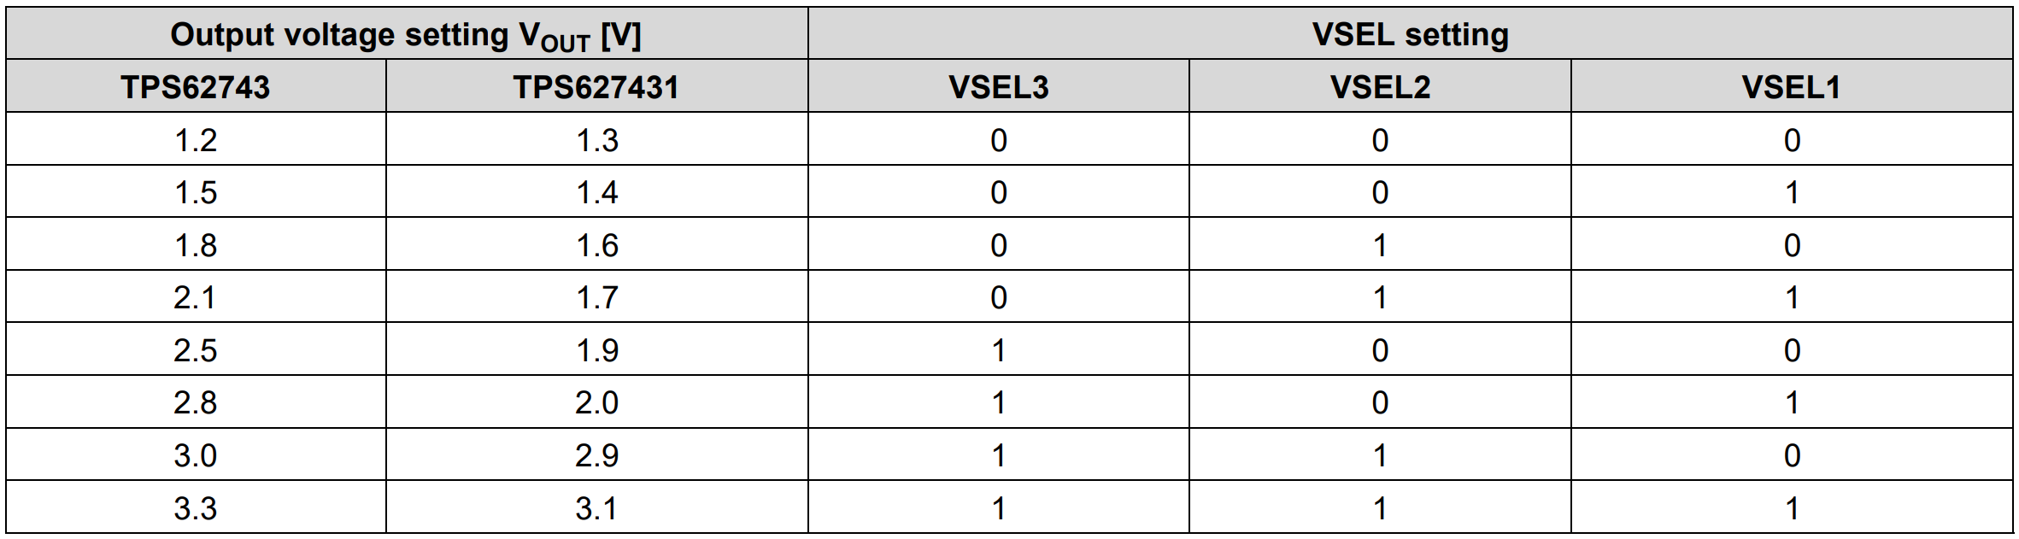
Report/Figures/Buck converter Vsel.PNG
