Jurriz/VHF-Unit/Report/Figures/Buck converter.PNG

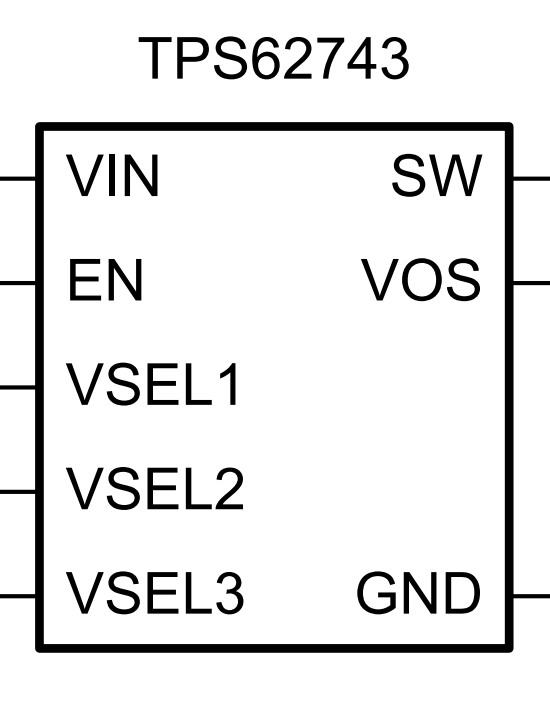
Report/Figures/Buck converter.PNG
