Jurriz/VHF-Unit/Report/Figures/Frequencyresponce_voltage.PNG

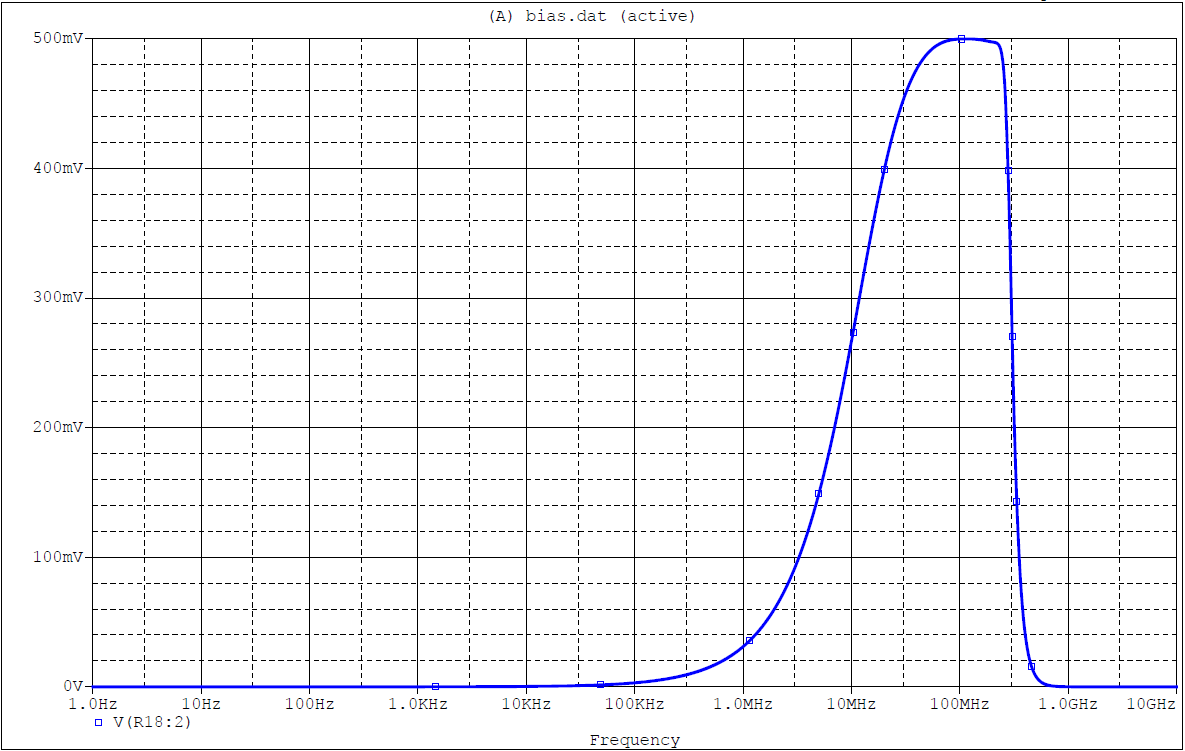
Report/Figures/Frequencyresponce_voltage.PNG
