Jurriz/VHF-Unit/Report/Figures/layout_2_china.png

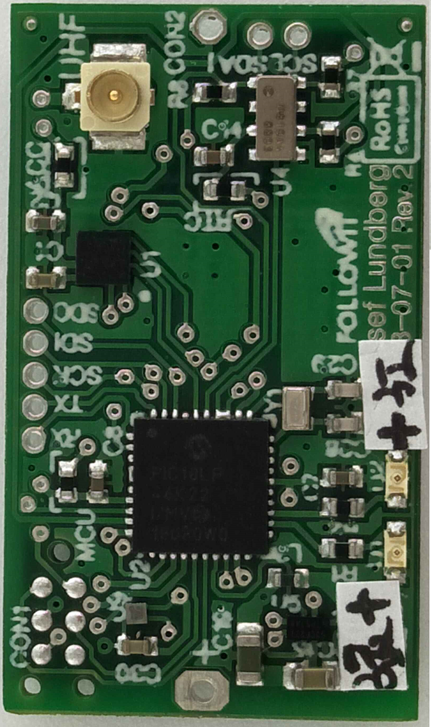
Report/Figures/layout_2_china.png
