Jurriz/VHF-Unit/Report/Figures/layout_2_china_b.png

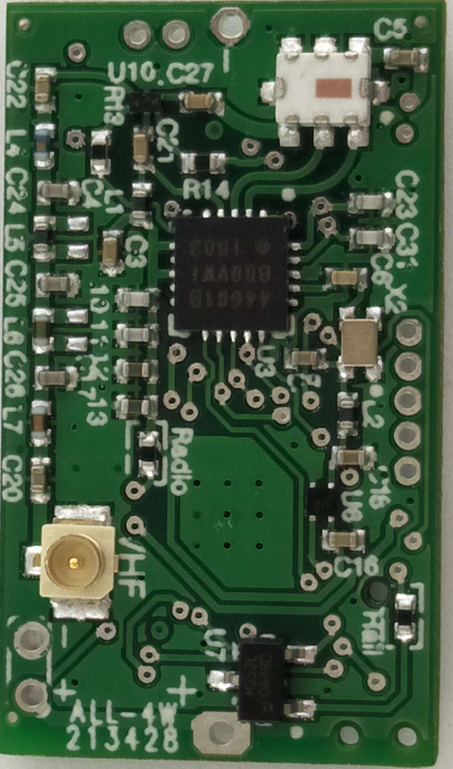
Report/Figures/layout_2_china_b.png
