Jurriz/VHF-Unit/Report/Figures/LIS2DW12.PNG

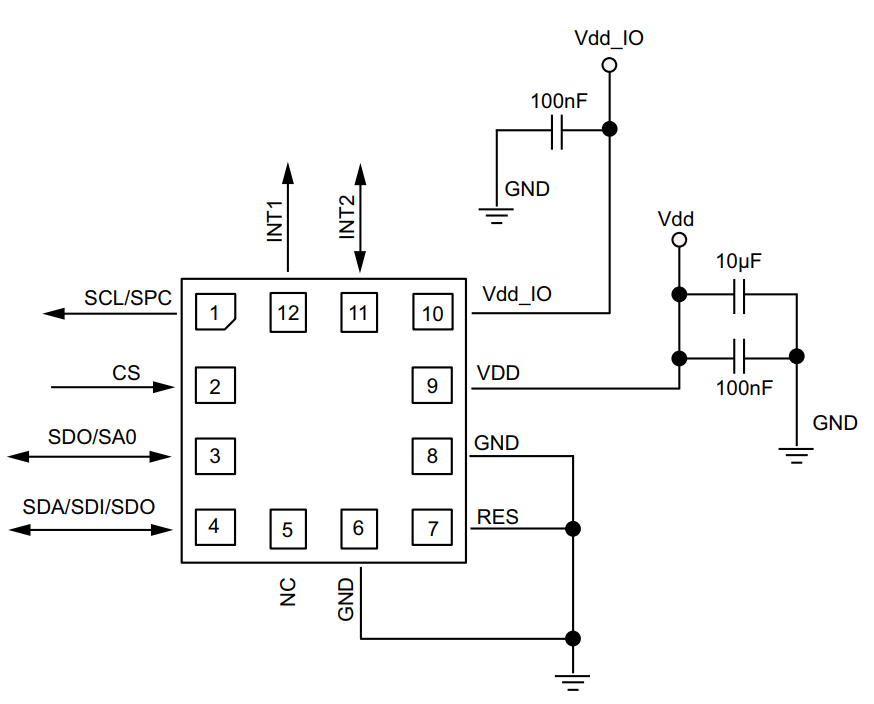
Report/Figures/LIS2DW12.PNG
