Jurriz/VHF-Unit/Report/Figures/PCB_3D.PNG

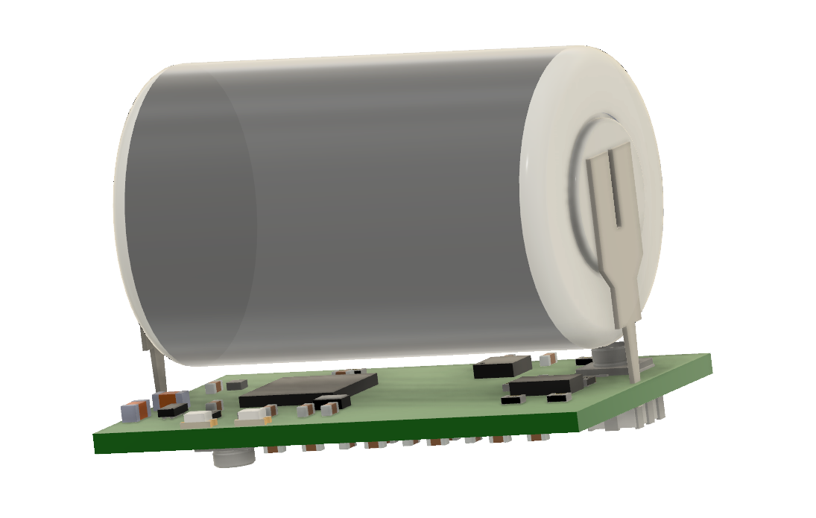
Report/Figures/PCB_3D.PNG
