Jurriz/VHF-Unit/Report/Figures/RF-switch.PNG

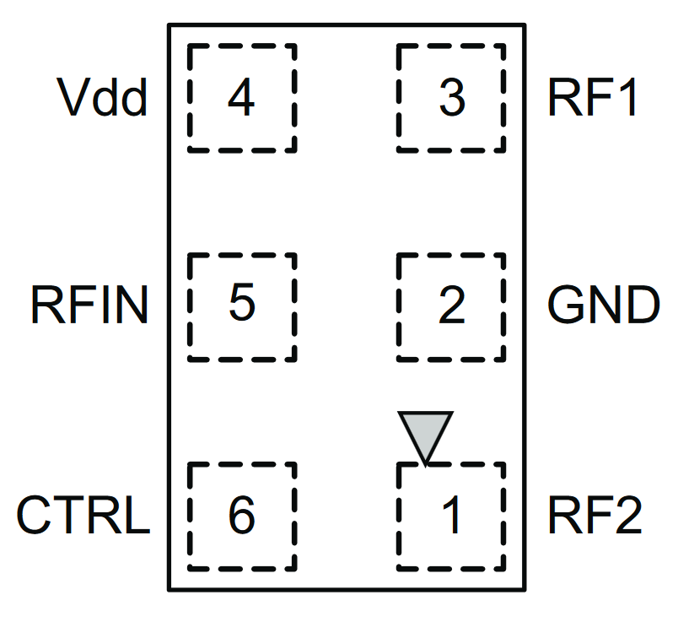
Report/Figures/RF-switch.PNG
