Jurriz/VHF-Unit/Report/Figures/RTC-pinout.PNG

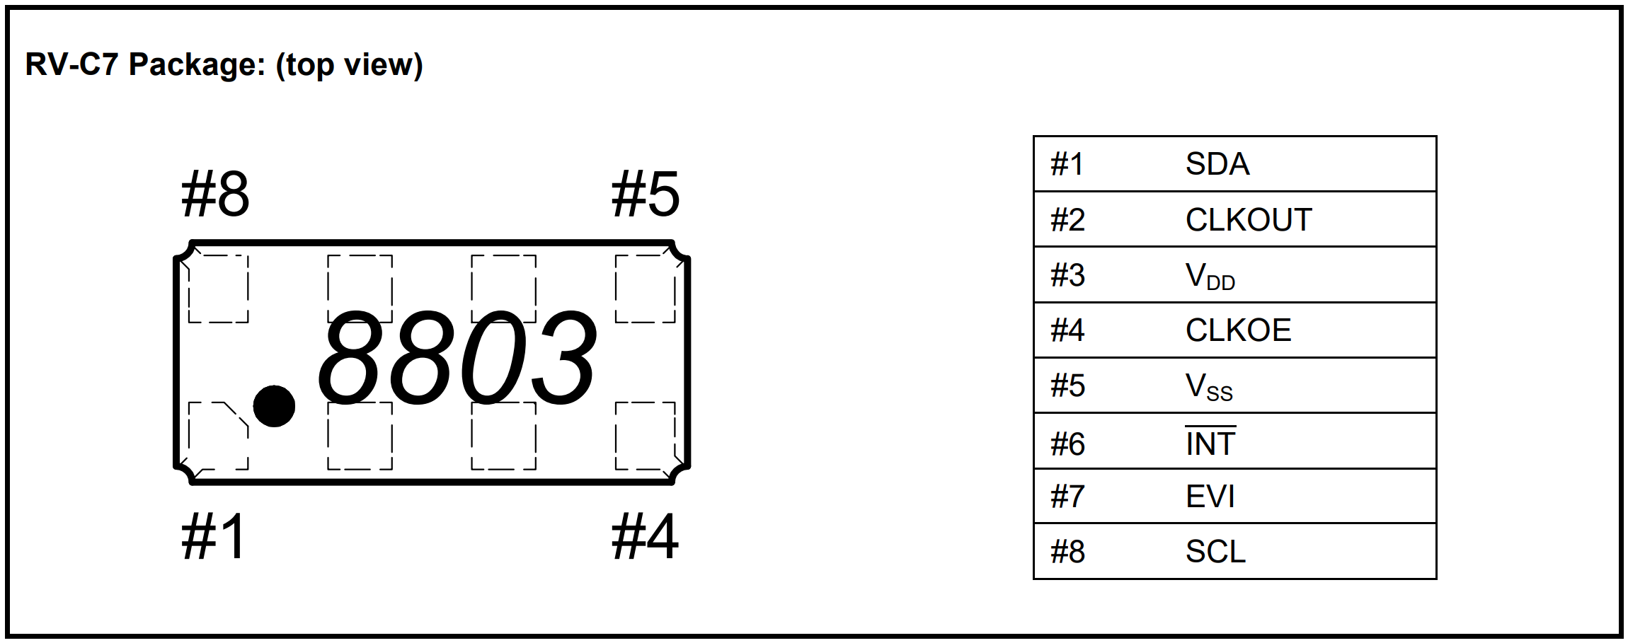
Report/Figures/RTC-pinout.PNG
