Jurriz/VHF-Unit/Report/Figures/si4460.PNG

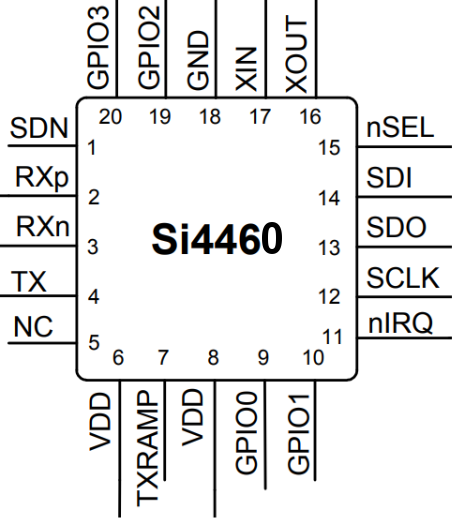
Report/Figures/si4460.PNG
