Jurriz/VHF-Unit/Report/Figures/Skineffect.png

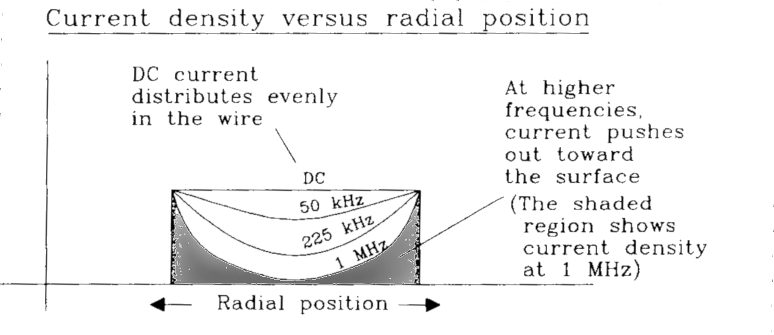
Report/Figures/Skineffect.png
