Jurriz/VHF-Unit/Report/Figures/System_overview.png

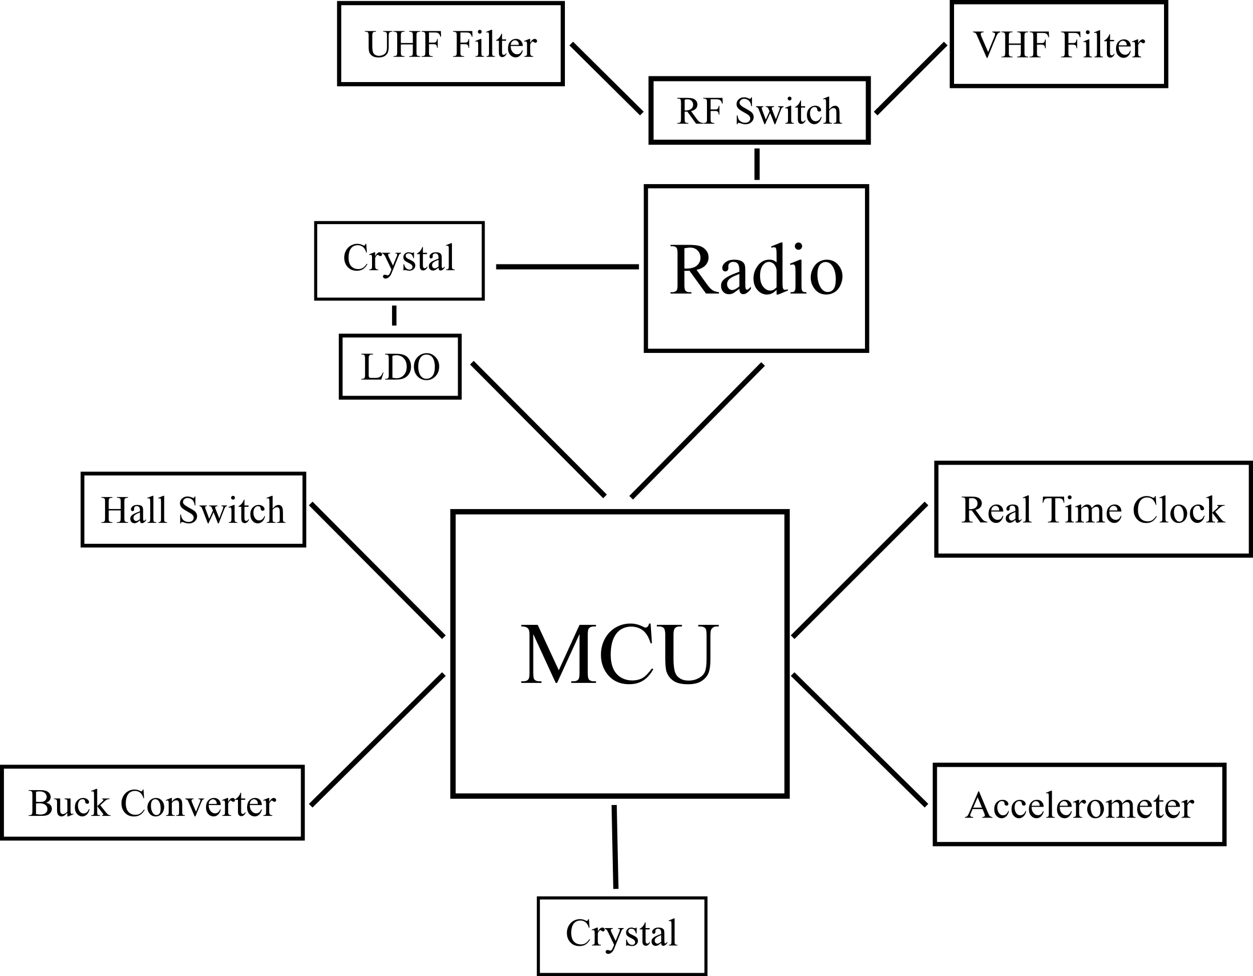
Report/Figures/System_overview.png
