Jurriz/VHF-Unit/Report/Gamla filer/Report LAtaex/Figures/DSC_0103.JPG

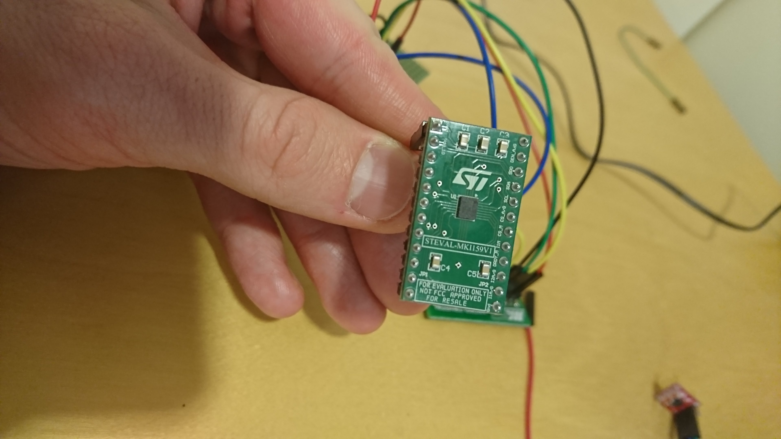
Report/Gamla filer/Report LAtaex/Figures/DSC_0103.JPG
