Jurriz/VHF-Unit/Report/Gamla filer/Report LAtaex/Figures/Schematic.png

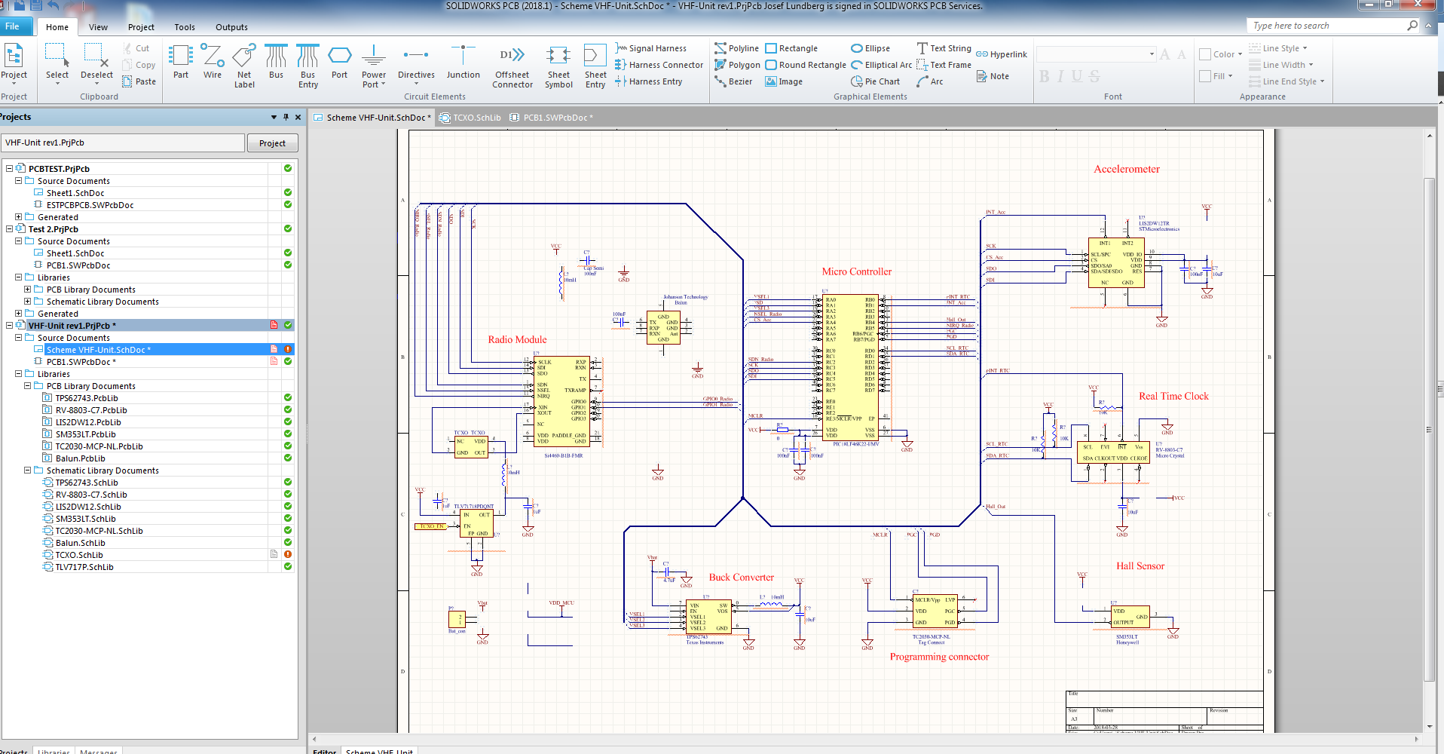
Report/Gamla filer/Report LAtaex/Figures/Schematic.png
