Jurriz/VHF-Unit/peekypokey/wiki/downloadWiki/docs/HomeAutomation_parts.JPG

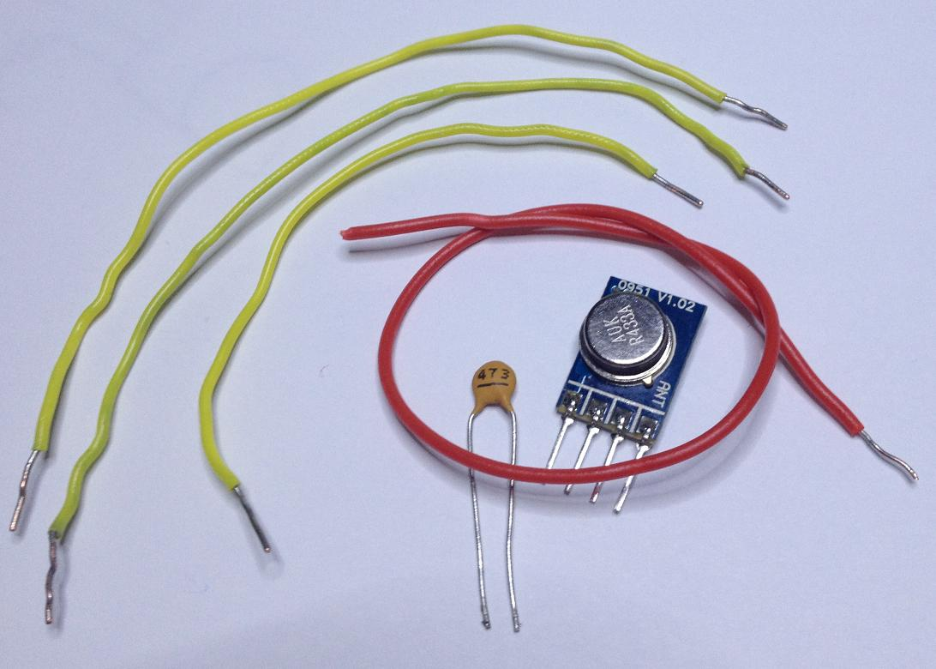
peekypokey/wiki/downloadWiki/docs/HomeAutomation_parts.JPG
