Jurriz/VHF-Unit/peekypokey/wiki/downloadWiki/docs/Automated water filling system_setup.PNG

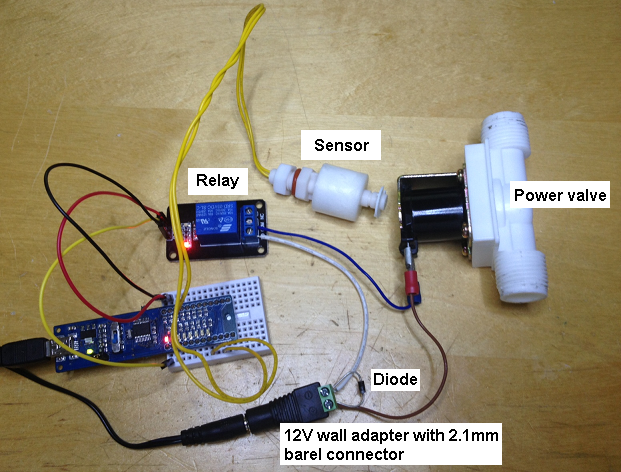
peekypokey/wiki/downloadWiki/docs/Automated water filling system_setup.PNG
