Jurriz/VHF-Unit/peekypokey/wiki/downloadWiki/docs/Controlling a relay_wiring.JPG

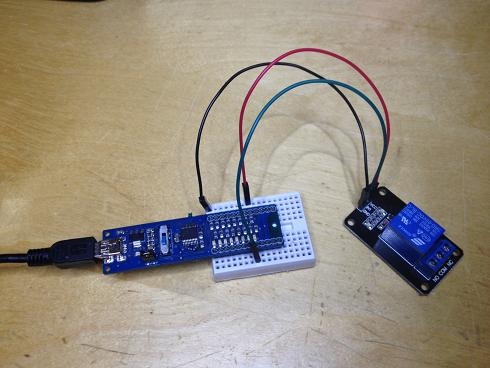
peekypokey/wiki/downloadWiki/docs/Controlling a relay_wiring.JPG
