Jurriz/VHF-Unit/peekypokey/wiki/downloadWiki/docs/MFRC522_wiring.JPG

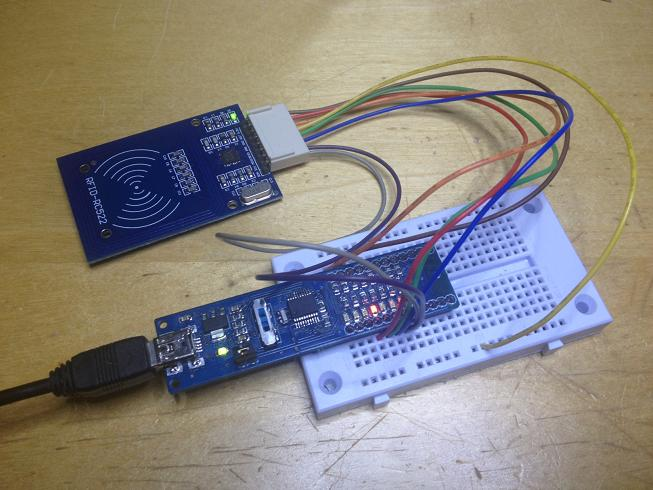
peekypokey/wiki/downloadWiki/docs/MFRC522_wiring.JPG
