Jurriz/VHF-Unit/peekypokey/wiki/downloadWiki/docs/PIRexample_pir_wiring.JPG

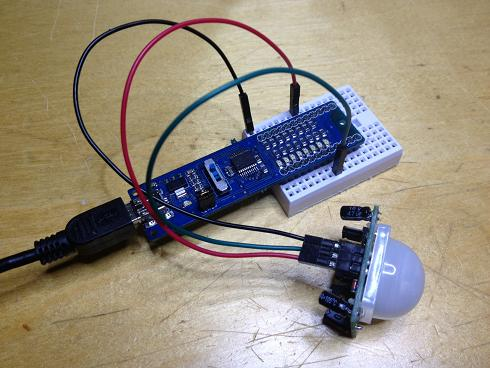
peekypokey/wiki/downloadWiki/docs/PIRexample_pir_wiring.JPG
