Jurriz/VHF-Unit/peekypokey/wiki/downloadWiki/docs/Reading a 4 by 4 keypad_wiring_small.JPG

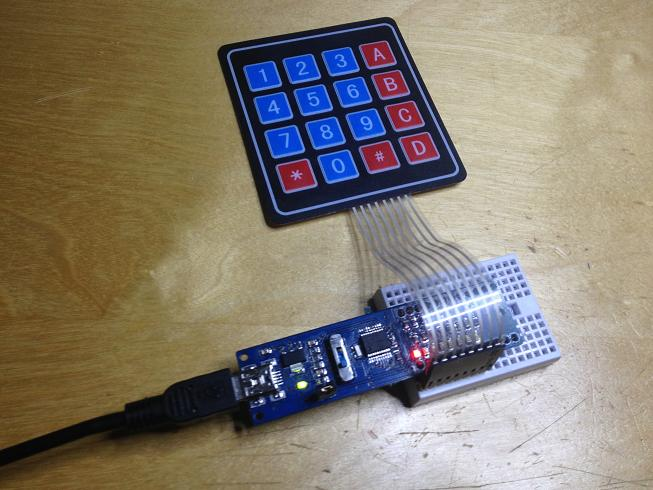
peekypokey/wiki/downloadWiki/docs/Reading a 4 by 4 keypad_wiring_small.JPG
