Jurriz/VHF-Unit/peekypokey/wiki/downloadWiki/docs/RotaryVolume_wiring.JPG

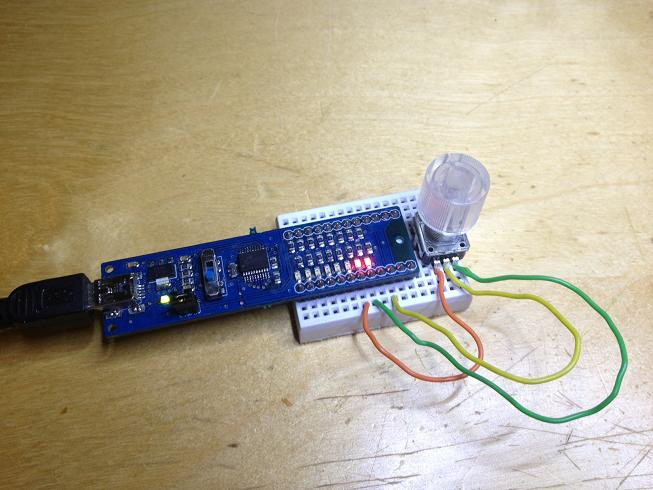
peekypokey/wiki/downloadWiki/docs/RotaryVolume_wiring.JPG
