Jurriz/VHF-Unit/Report/Figures/Frequencyresponce.pdf

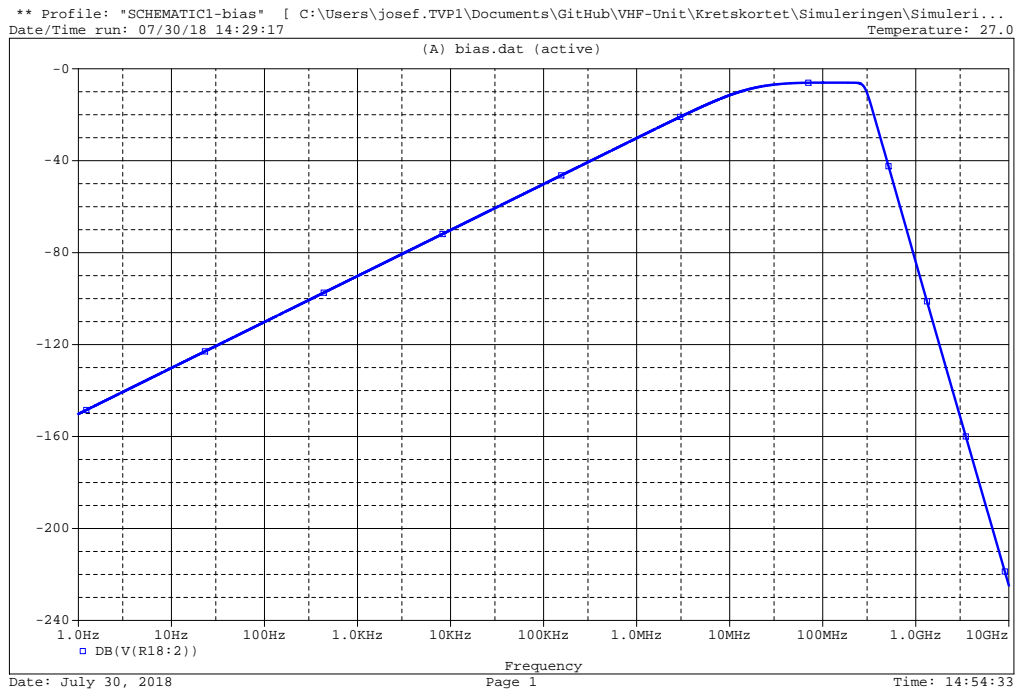
[picture p78: page 1]
Temperature: 27.0; Date: July 30, 2018; Page 1; Time: 14:54:33; Frequency; 1.0KHz; 10KHz; 100KHz; 1.0MHz; 10MHz; 100MHz; 1.0GHz; 10GHz

** Profile: "SCHEMATIC1-bias" [ C:\Users\josef.TVP1\Documents\GitHub\VHF-Unit\Kretskortet\Simuleringen\Simuleri...
Date/Time run: 07/30/18 14:29:17

(A) bias.dat (active)
