Jurriz/VHF-Unit/Report/Figures/Schema_MCU-rotated.pdf

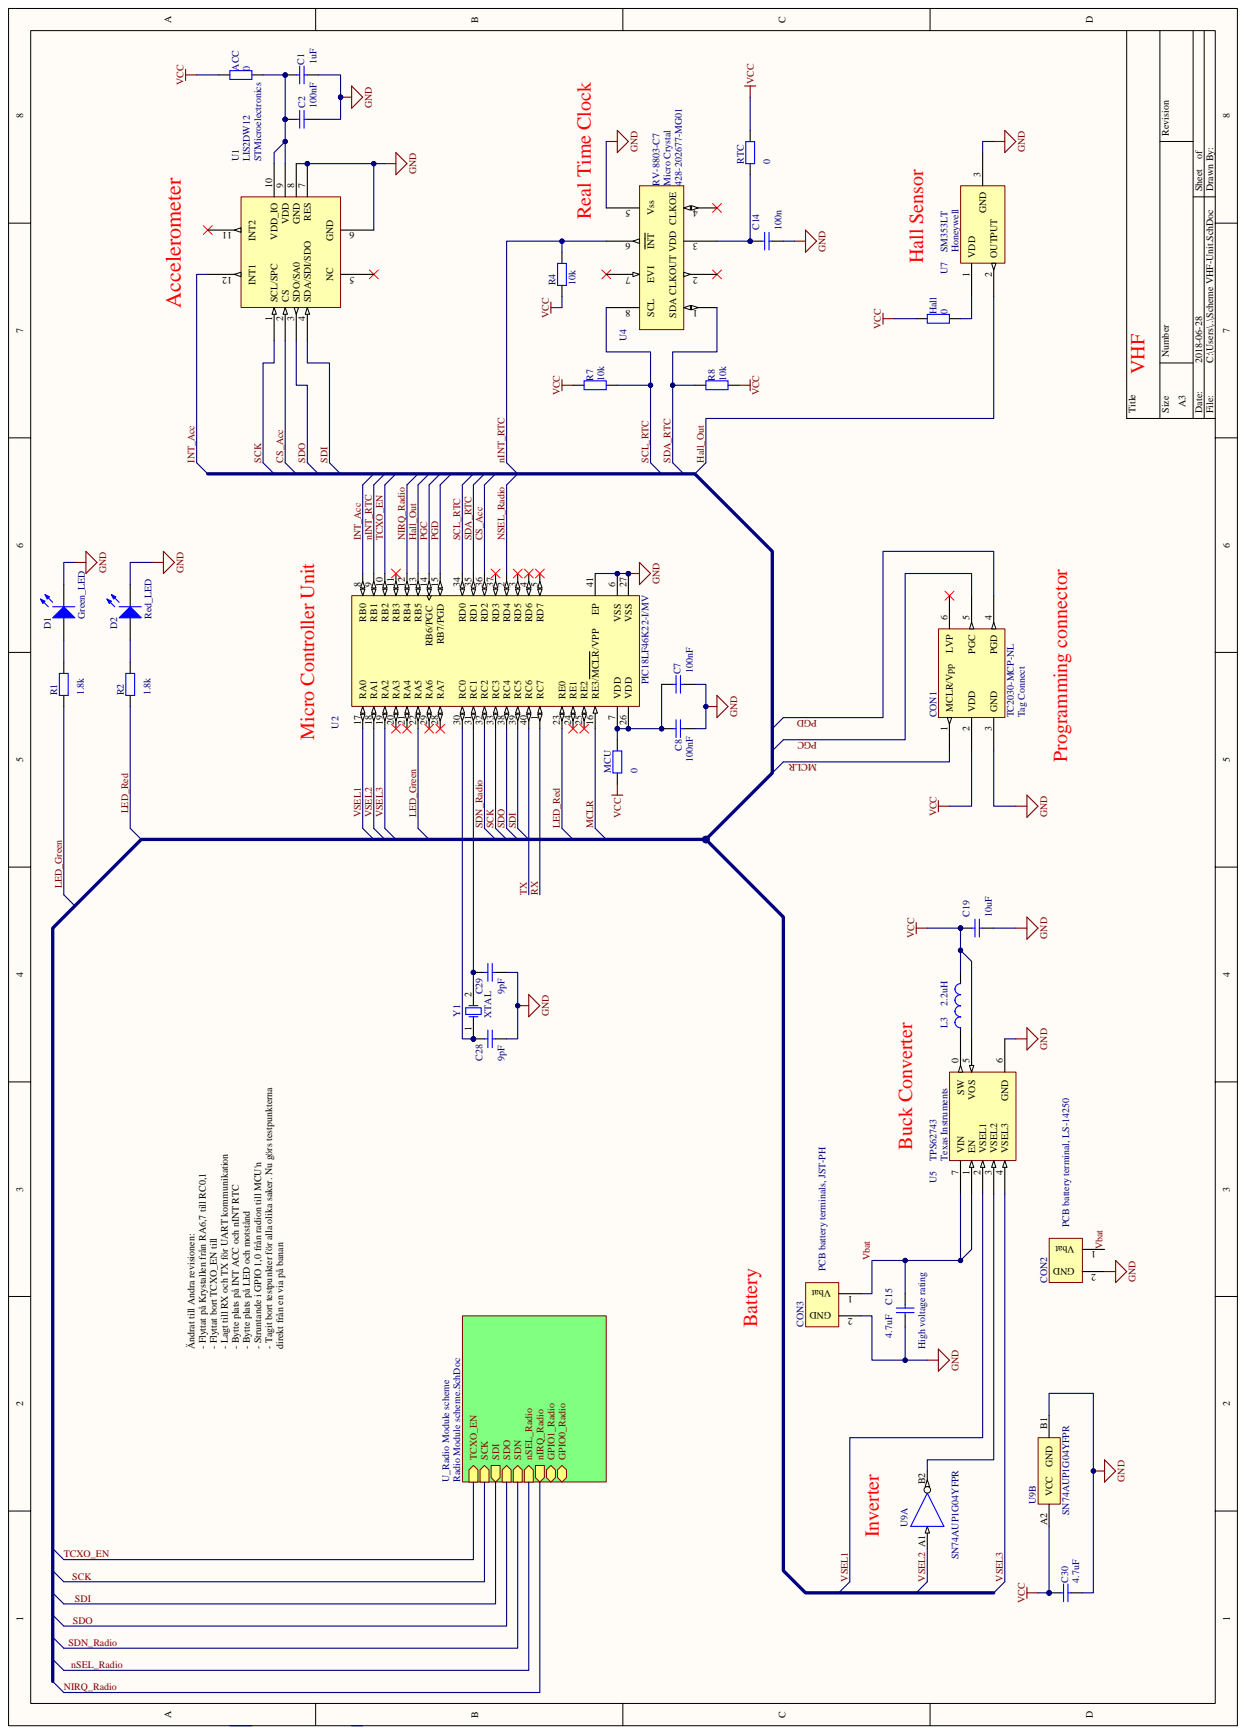
[picture p79: page 1]

File: C:\Users\..\Scheme VHF-Unit.SchDoc Drawn By:

- Tagit bort testpunkter för alla olika saker. Nu görs testpunkterna

PCB battery terminal, LS-14250

PCB battery terminals, JST-PH

- Lagt till RX och TX för UART kommunikation

- Struntande i GPIO 1,0 från radion till MCU'n

- Flyttat på Krystallen från RA6,7 till RC0,1

- Bytte plats på INT ACC och nINT RTC

- Bytte plats på LED och motstånd

Ändrat till Andra revisionen:

direkt från en via på banan

Radio Module scheme.SchDoc
