Jurriz/VHF-Unit/Report/Figures/Schema_MCU.pdf

# Micro Controller Unit

# Accelerometer

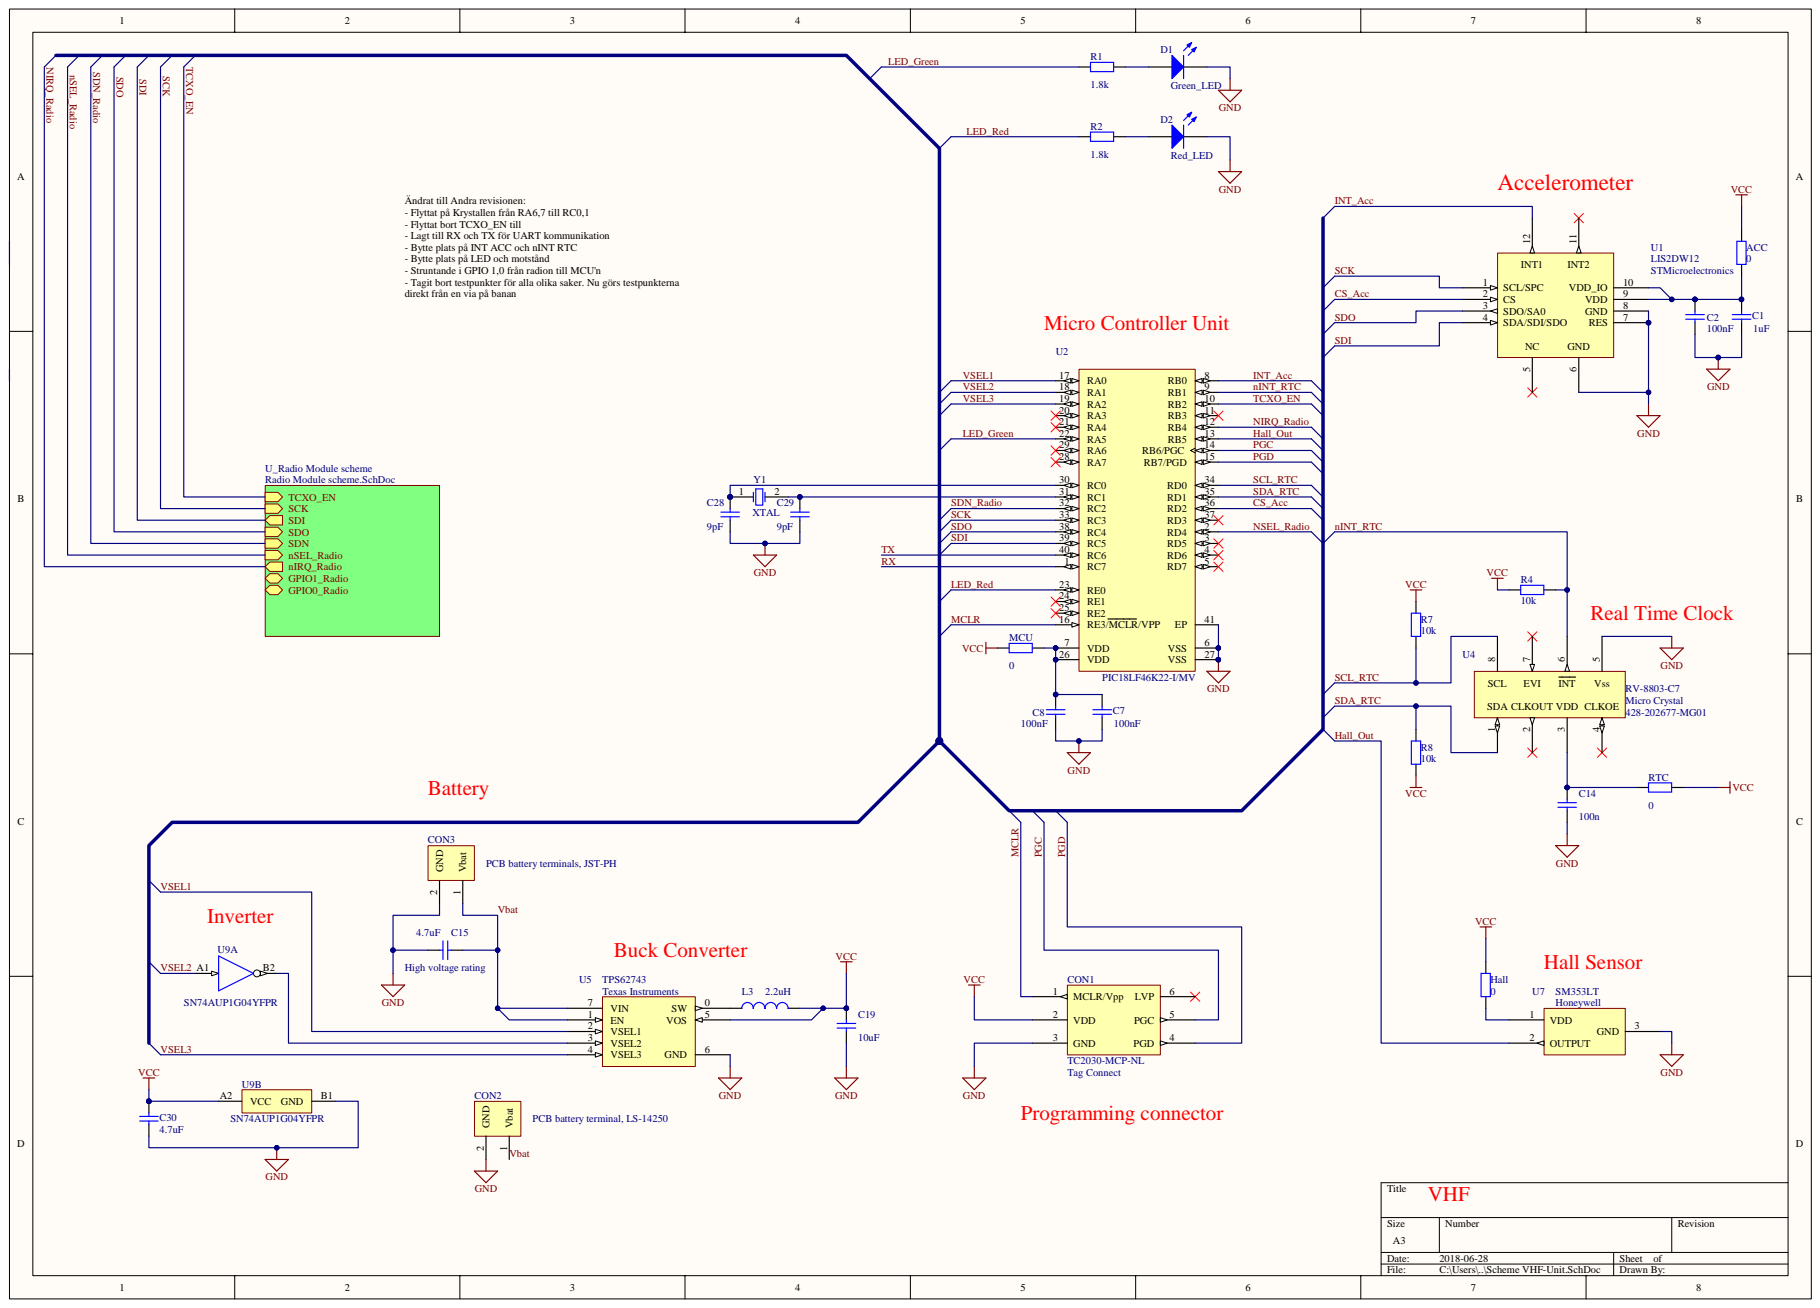
[picture p80: page 1]

Ändrat till Andra revisionen:
- Flyttat på Krystallen från RA6,7 till RC0,1
- Flyttat bort TCXO_EN till
- Lagt till RX och TX för UART kommunikation
- Bytte plats på INT ACC och nINT RTC
- Bytte plats på LED och motstånd
- Struntande i GPIO 1,0 från radion till MCU'n
- Tagit bort testpunkter för alla olika saker. Nu görs testpunkterna
direkt från en via på banan

Vbat
PCB battery terminals, JST-PH

PCB battery terminal, LS-14250

Size A3 | Number | Revision

Date: 2018-06-28 | Sheet of
File: C:\Users\..\Scheme VHF-Unit.SchDoc | Drawn By:
