Jurriz/VHF-Unit/Report/Figures/Schema_radio-rotated.pdf

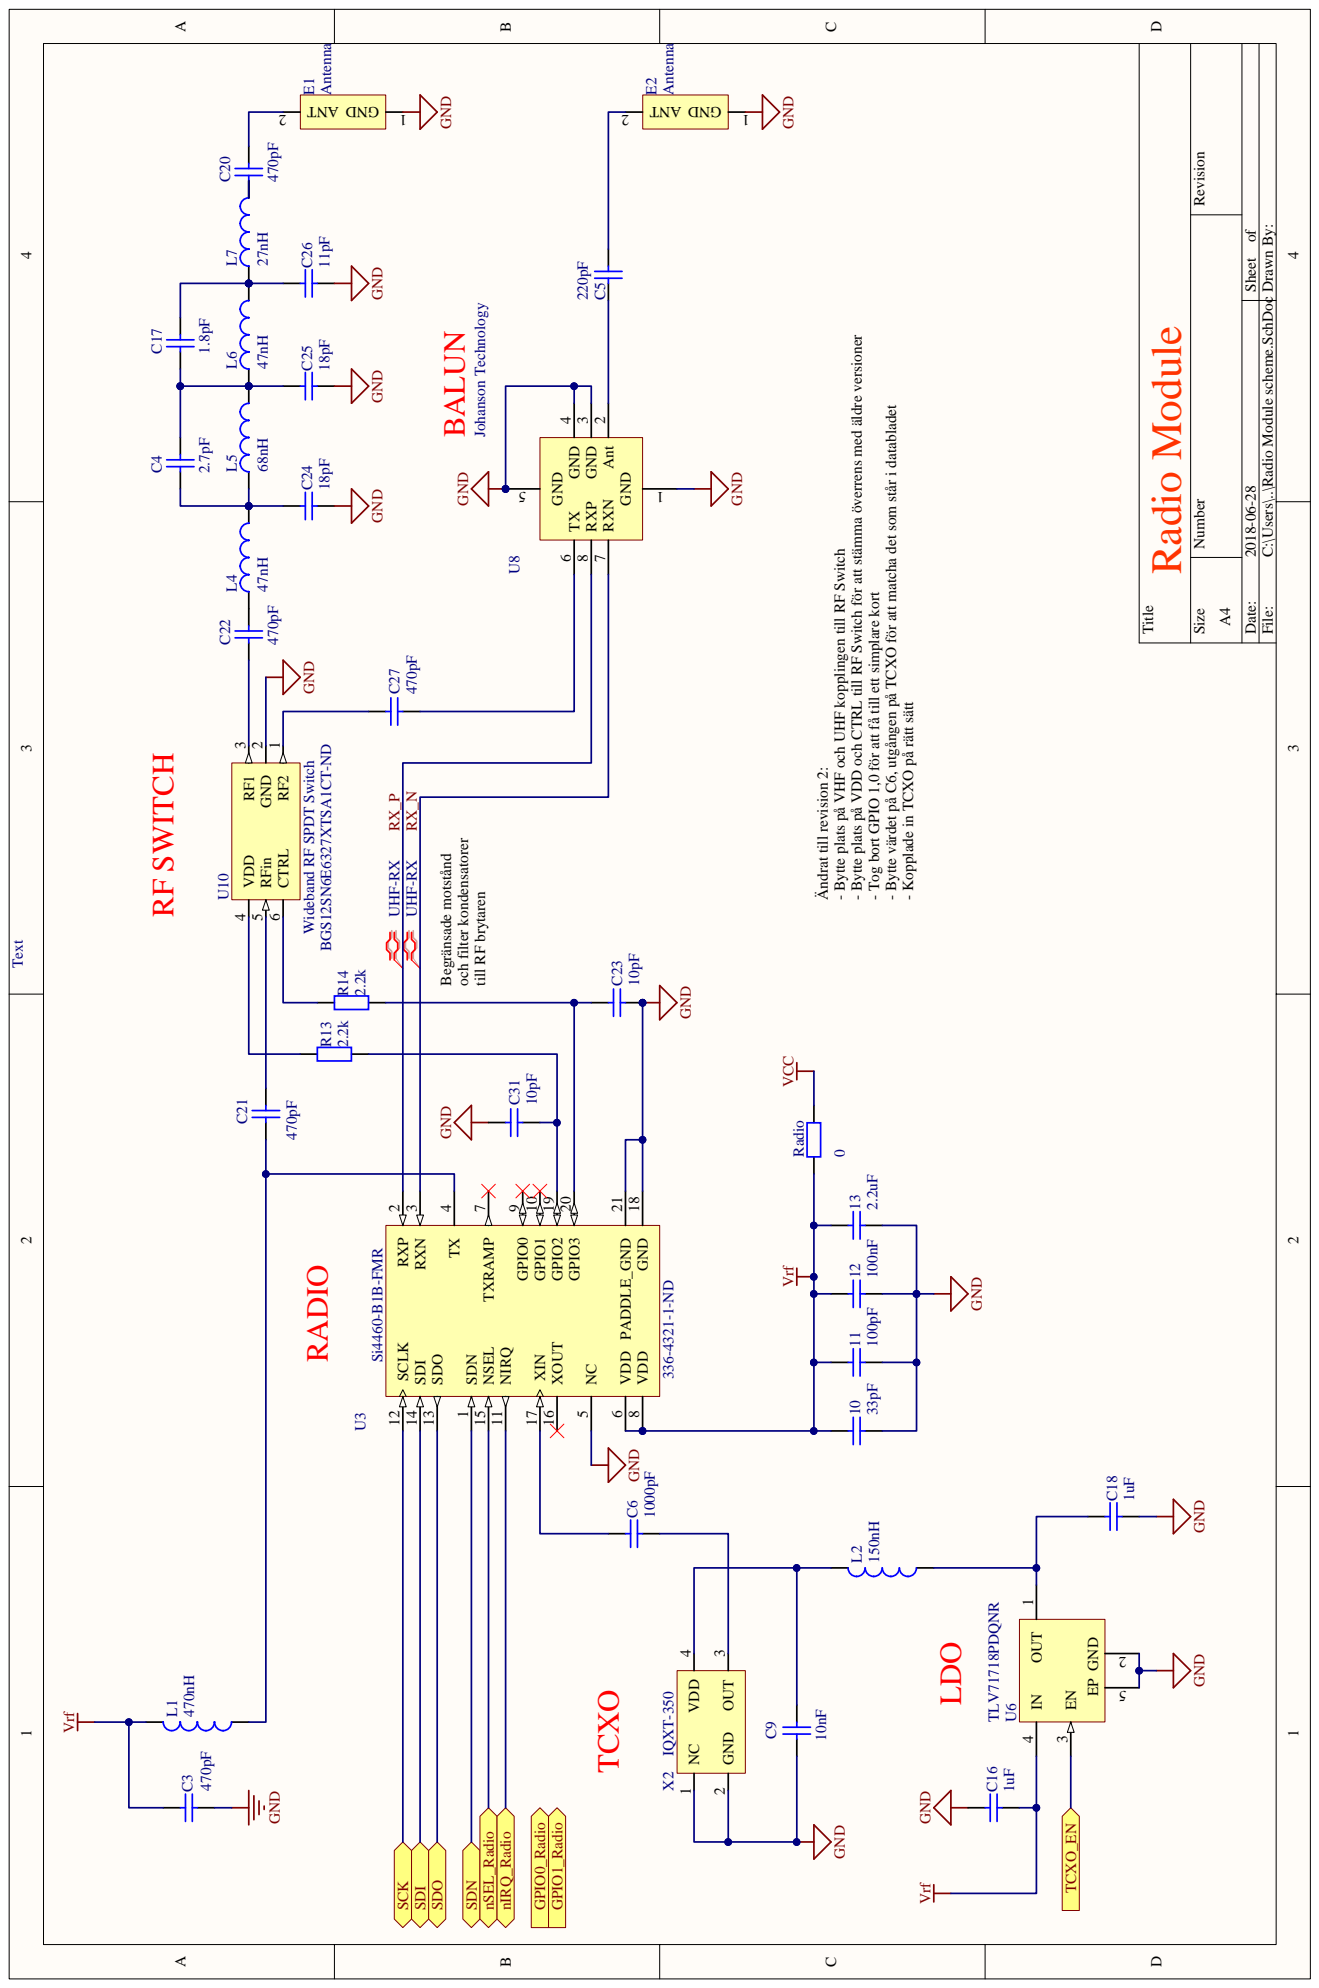
[picture p81: page 1]

File: C:\Users\..\Radio Module scheme.SchDoc Drawn By:

BALUN Begränsade motstånd och filter kondensatorer

- Bytte plats på VDD och CTRL till RF Switch för att stämma överrens med äldre versioner

Ant 2 GND 3 GND 4 GND

- Bytte värdet på C6, utgången på TCXO för att matcha det som står i databladet

- Bytte plats på VHF och UHF kopplingen till RF Switch

- Tog bort GPIO 1,0 för att få till ett simplare kort

- Kopplade in TCXO på rätt sätt

RF2 1 GND 2 RF1 3 VDD 4 RFin 5 CTRL 6

Wideband RF SPDT Switch
