Jurriz/VHF-Unit/Report/Figures/Schema_radio.pdf

# RF SWITCH

# RADIO

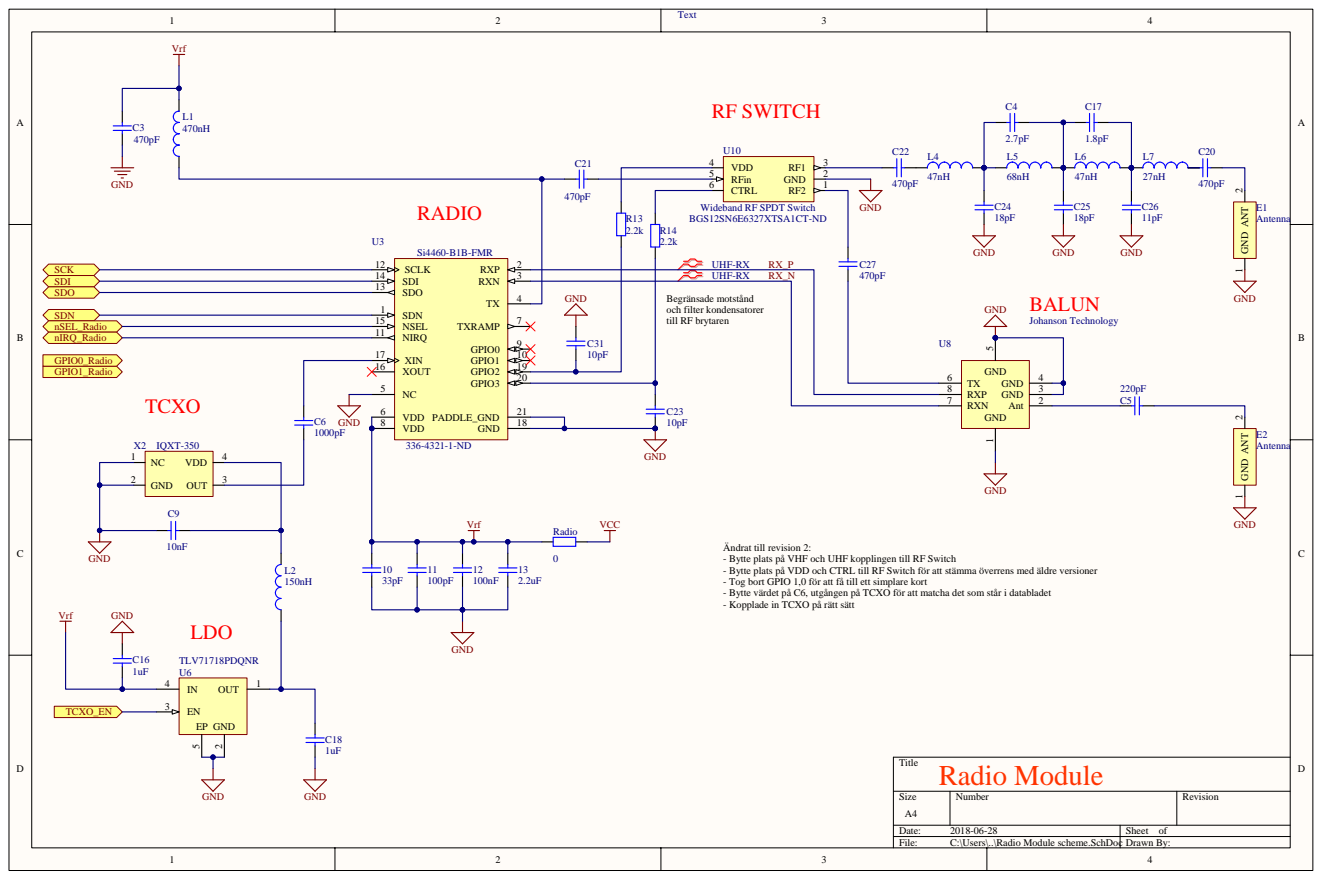
[picture p82: page 1]

1 | 2 | Text 3 | 4

Vrf

BALUN Begränsade motstånd och filter kondensatorer

Ändrat till revision 2:
- Bytte plats på VHF och UHF kopplingen till RF Switch
- Bytte plats på VDD och CTRL till RF Switch för att stämma överrens med äldre versioner
- Tog bort GPIO 1,0 för att få till ett simplare kort
- Bytte värdet på C6, utgången på TCXO för att matcha det som står i databladet
- Kopplade in TCXO på rätt sätt

Size A4 | Number | Revision

Date: 2018-06-28 | Sheet of
File: C:\Users\..\Radio Module scheme.SchDoc Drawn By:
