Jurriz/VHF-Unit/Report/Figures/Cheb_LoPa_6.pdf

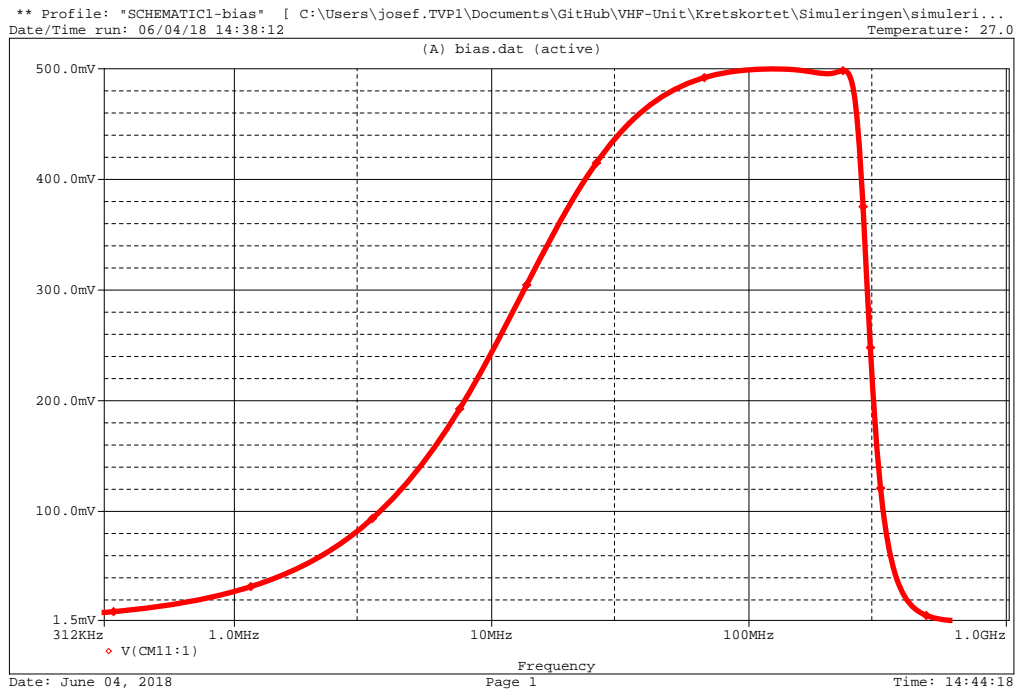
[picture p83: page 1]
Temperature: 27.0; Date: June 04, 2018; Page 1; Time: 14:44:18; Frequency; 312KHz; 1.0MHz; 10MHz; 100MHz; 1.0GHz

** Profile: "SCHEMATIC1-bias" [ C:\Users\josef.TVP1\Documents\GitHub\VHF-Unit\Kretskortet\Simuleringen\simuleri...
Date/Time run: 06/04/18 14:38:12

(A) bias.dat (active)
