Jurriz/VHF-Unit/Kretskortet/[VHF-Unit rev1.PrjPcb] VHF-Unit rev1.pdf

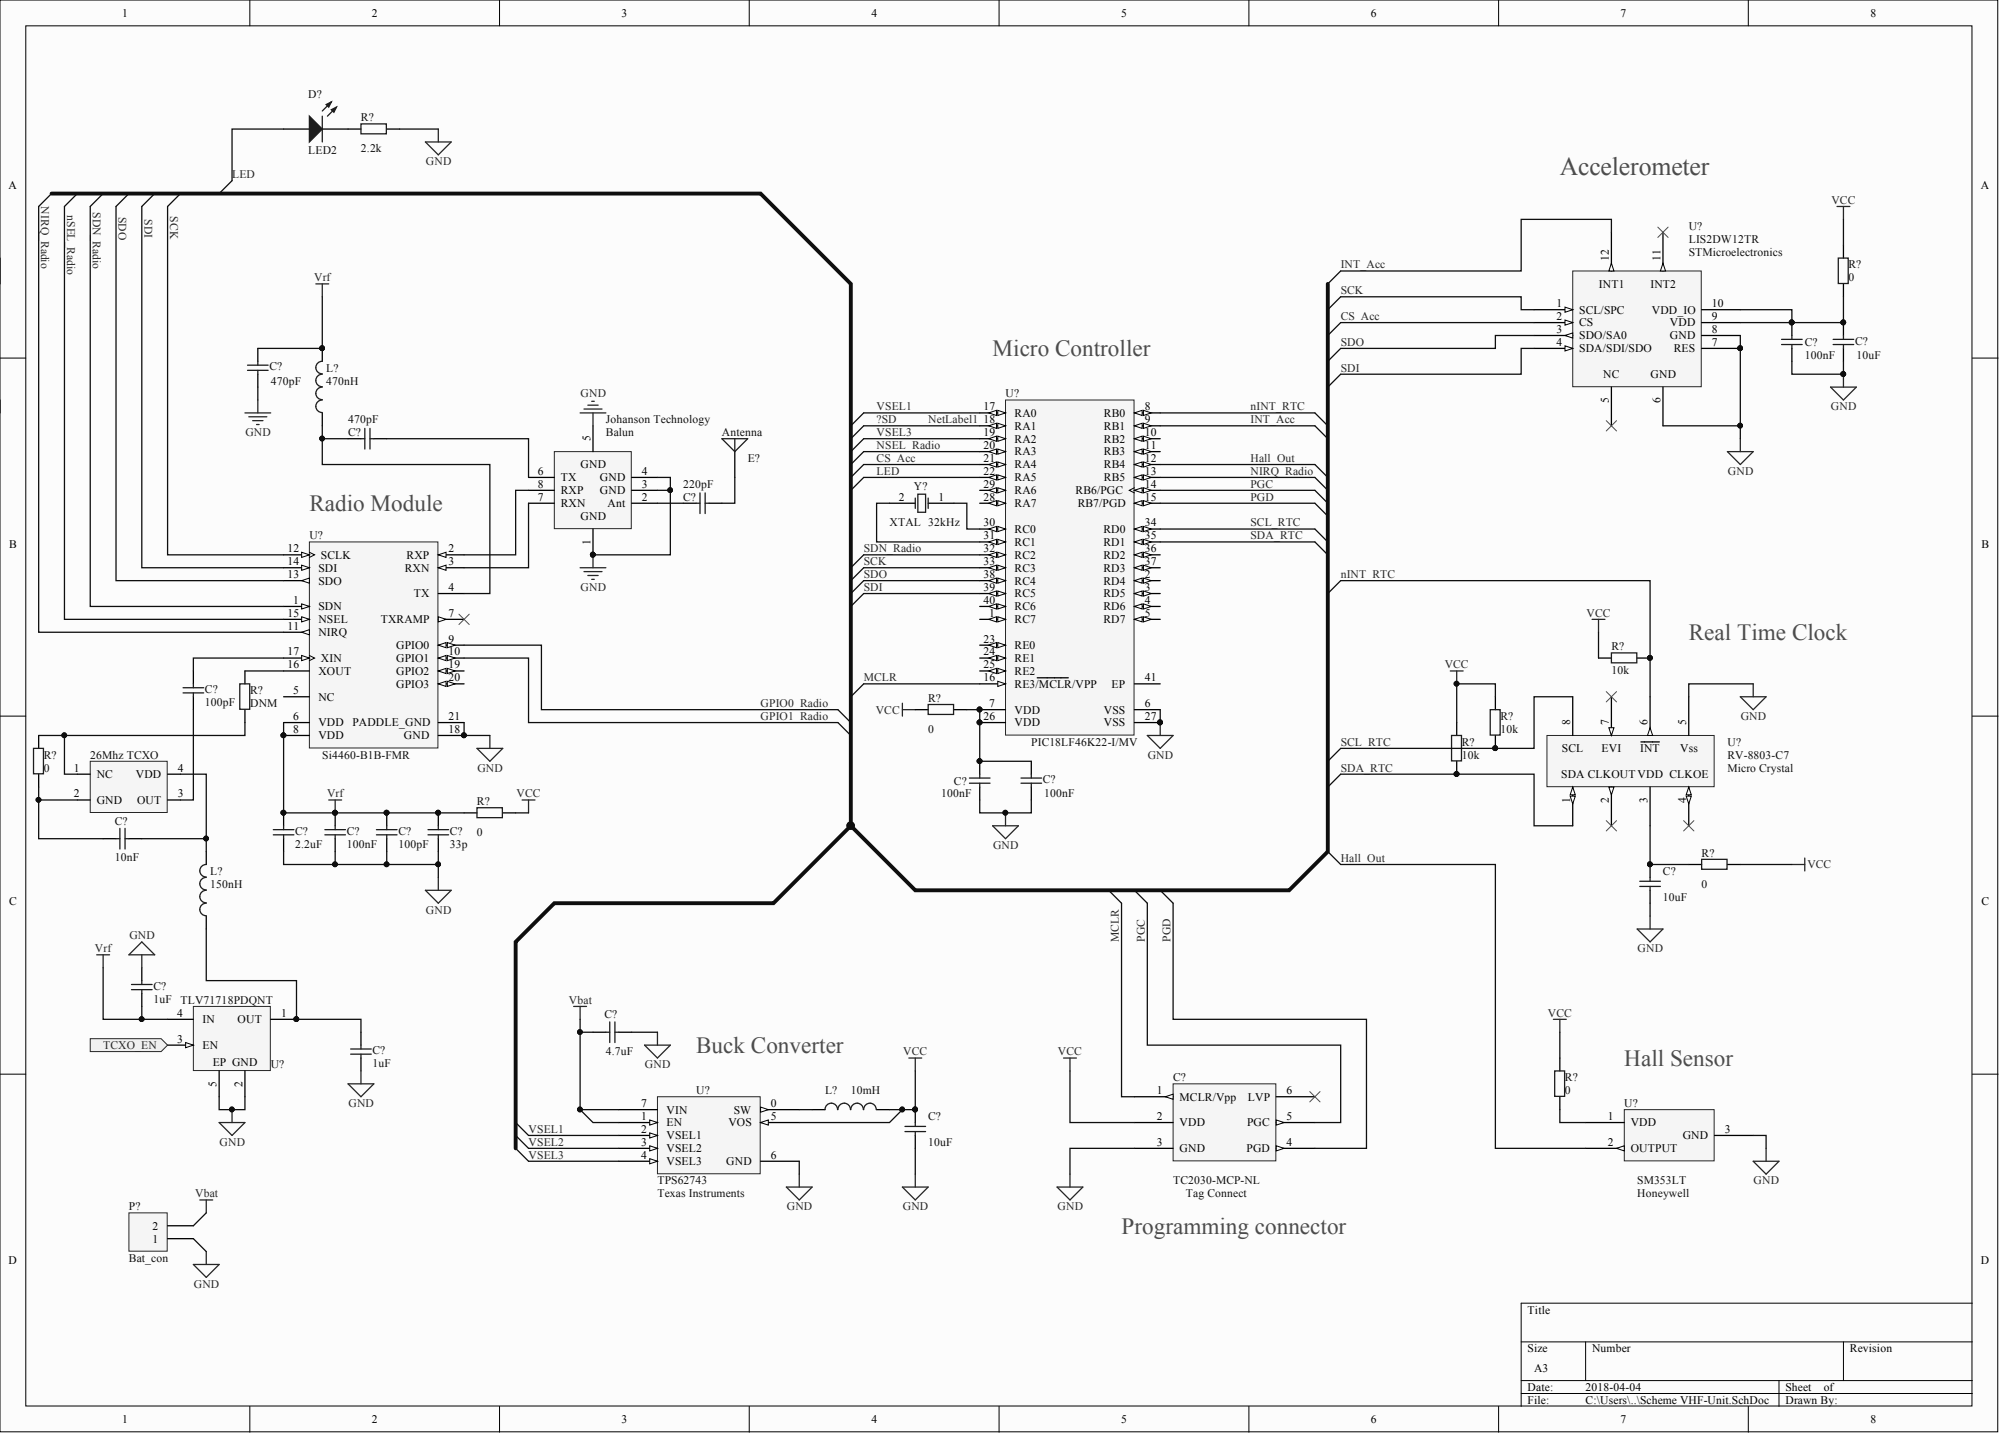
[picture p84: page 1]
Date:; Sheet of; File:; C:\Users\..\Scheme VHF-Unit.SchDoc; Drawn By:; SDN 1; VDD 6 VDD 8; NIRQ 11; SCLK 12; SDO 13; SDI 14; NSEL 15; XOUT 16; XIN 17; VSS; 6 VDD 7; RE3/MCLR/VPP 16; VDD 26; SCL/SPC 1 CS 2; RES; 7 GND; 8 VDD; 9 VDD_IO; VDD 1; OUTPUT 2; GND; 4 Vss; Buck Converter; Tag Connect; MCLR/Vpp 1; VDD 2; GND 3; PGD; Micro Controller; Radio Module; Programming connector; Hall Sensor; Texas Instruments; EN 1 VSEL1 2 VSEL2 3 VSEL3 4; VIN 7; Ant; 2 GND; 3 GND; 4 GND; RXN 7; RXP 8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

SDO/SA0 3 | PIC?02

NLSDO SDO

PIU?03
SDA/SDI/SDO 4

VCC
PIU?08 PIU?07 PIU?06 PIU?05

Real Time Clock

PIU?01 PIU?02 PIU?03 PIU?04

SCL
Micro Crystal SDA
CLKOUT
PIU?02
