Jurriz/VHF-Unit/(list of files, drawings)

Other design files:
Kretskortet/Simuleringen/DESIGN1.DSN
Kretskortet/Simuleringen/Design1.opj
Kretskortet/Simuleringen/Simulering.dsn
Kretskortet/Simuleringen/Simulering.opj
Kretskortet/Simuleringen/Simulering/Sheet1.SchDoc
Kretskortet/Simuleringen/Simulering/Simulering.PrjPcb
