Jurriz/VHF-Unit/Koden/Main.c

#include <p18f46k22.h>
#include <stdlib.h>
#include <stdio.h>
#include <string.h>
#include <timers.h>
#include <usart.h>
#include <spi.h>
#include <i2c.h>
#include <delays.h>
#include <adc.h>

#include "Header_h.h"

// -----------------------------------------------------------------------------
// PIC18LF46k22 
/*
#pragma config DEBUG = ON        // Debugger 
#pragma config XINST = ON       // Extended instruction set  

#pragma config STVREN = 1       // Stack overflow reset enable
#pragma config WDTEN = OFF      // Watchdog timer enable
#pragma config CP0 = OFF        // Code protection

#pragma config FCMEN = OFF
#pragma config IESO = OFF

#pragma config PRICLKEN = ON

//#pragma config FOSC = LFINTOSC


#pragma config WDTPS = 32
#pragma config FOSC = XT             //ÄNDRAT från HS till XT
//#pragma config WAIT = OFF             ÄNDRAT
//#pragma config BW = 8                 ÄNDRAT
//#pragma config MODE = MM              ÄNDRAT
#define _XTAL_FREQ  32678
// -----------------------------------------------------------------------------
*/

#pragma config FOSC = INTIO67    // Oscillator Selection bits->Internal oscillator block
#pragma config PLLCFG = OFF    // 4X PLL Enable->Oscillator used directly
#pragma config PRICLKEN = ON    // Primary clock enable bit->Primary clock is always enabled
#pragma config FCMEN = OFF    // Fail-Safe Clock Monitor Enable bit->Fail-Safe Clock Monitor disabled
#pragma config IESO = OFF    // Internal/External Oscillator Switchover bit->Oscillator Switchover mode disabled

//// CONFIG2L
//#pragma config PWRTEN = OFF    // Power-up Timer Enable bit->Power up timer disabled
//#pragma config BOREN = OFF    // Brown-out Reset Enable bits->Brown-out Reset enabled in hardware only (SBOREN is disabled)
//#pragma config BORV = 190    // Brown Out Reset Voltage bits->VBOR set to 1.90 V nominal
//
//// CONFIG2H
//#pragma config WDTEN = OFF    // Watchdog Timer Enable bits->WDT is controlled by SWDTEN bit of the WDTCON register
//#pragma config WDTPS = 32768    // Watchdog Timer Postscale Select bits->1:32768

// CONFIG3H
#pragma config CCP2MX = PORTC1    // CCP2 MUX bit->CCP2 input/output is multiplexed with RC1
#pragma config PBADEN = ON    // PORTB A/D Enable bit->PORTB<5:0> pins are configured as analog input channels on Reset
#pragma config CCP3MX = PORTB5    // P3A/CCP3 Mux bit->P3A/CCP3 input/output is multiplexed with RB5
#pragma config HFOFST = ON    // HFINTOSC Fast Start-up->HFINTOSC output and ready status are not delayed by the oscillator stable status
#pragma config T3CMX = PORTC0    // Timer3 Clock input mux bit->T3CKI is on RC0
#pragma config P2BMX = PORTD2    // ECCP2 B output mux bit->P2B is on RD2
#pragma config MCLRE = EXTMCLR    // MCLR Pin Enable bit->MCLR pin enabled, RE3 input pin disabled

//// CONFIG4L
#pragma config STVREN = ON    // Stack Full/Underflow Reset Enable bit->Stack full/underflow will cause Reset
#pragma config LVP = ON    // Single-Supply ICSP Enable bit->Single-Supply ICSP enabled if MCLRE is also 1
#pragma config XINST = ON    // Extended Instruction Set Enable bit->Instruction set extension and Indexed Addressing mode disabled (Legacy mode)
#pragma config DEBUG = ON    // Background Debug->Disabled
//
//// CONFIG5L
//#pragma config CP0 = OFF    // Code Protection Block 0->Block 0 (000800-003FFFh) not code-protected
//#pragma config CP1 = OFF    // Code Protection Block 1->Block 1 (004000-007FFFh) not code-protected
//#pragma config CP2 = OFF    // Code Protection Block 2->Block 2 (008000-00BFFFh) not code-protected
//#pragma config CP3 = OFF    // Code Protection Block 3->Block 3 (00C000-00FFFFh) not code-protected
//
//// CONFIG5H
//#pragma config CPB = OFF    // Boot Block Code Protection bit->Boot block (000000-0007FFh) not code-protected
//#pragma config CPD = OFF    // Data EEPROM Code Protection bit->Data EEPROM not code-protected
//
//// CONFIG6L
//#pragma config WRT0 = OFF    // Write Protection Block 0->Block 0 (000800-003FFFh) not write-protected
//#pragma config WRT1 = OFF    // Write Protection Block 1->Block 1 (004000-007FFFh) not write-protected
//#pragma config WRT2 = OFF    // Write Protection Block 2->Block 2 (008000-00BFFFh) not write-protected
//#pragma config WRT3 = OFF    // Write Protection Block 3->Block 3 (00C000-00FFFFh) not write-protected
//
//// CONFIG6H
//#pragma config WRTC = OFF    // Configuration Register Write Protection bit->Configuration registers (300000-3000FFh) not write-protected
//#pragma config WRTB = OFF    // Boot Block Write Protection bit->Boot Block (000000-0007FFh) not write-protected
//#pragma config WRTD = OFF    // Data EEPROM Write Protection bit->Data EEPROM not write-protected
//
//// CONFIG7L
//#pragma config EBTR0 = OFF    // Table Read Protection Block 0->Block 0 (000800-003FFFh) not protected from table reads executed in other blocks
//#pragma config EBTR1 = OFF    // Table Read Protection Block 1->Block 1 (004000-007FFFh) not protected from table reads executed in other blocks
//#pragma config EBTR2 = OFF    // Table Read Protection Block 2->Block 2 (008000-00BFFFh) not protected from table reads executed in other blocks
//#pragma config EBTR3 = OFF    // Table Read Protection Block 3->Block 3 (00C000-00FFFFh) not protected from table reads executed in other blocks
//
//// CONFIG7H
//#pragma config EBTRB = OFF    // Boot Block Table Read Protection bit->Boot Block (000000-0007FFh) not protected from table reads executed in other blocks



// -----------------------------------------------------------------------------
char nByte_1, nByte_2;
char nTimeOutUSART_1, nTimeOutUSART_2;
char nCountToFive;
char filter;

volatile union 
{
	struct 
	{
		unsigned bTimerIRQ		:1;
		unsigned bReceived_1	:1;
		unsigned bReceived_2	:1;
		unsigned bReadInc		:1;
		unsigned bToggle		:1;
		unsigned bPassThrough	:1;
		unsigned bNMEA			:1;
		unsigned bNMEA_ON_Once	:1;
		unsigned bNMEA_OFF_Once	:1;
		unsigned bSPIbusy		:1;
	};
	long int AllMyFlags;
} FlagBits;


//#pragma udata USART_Buffer0
	char szUSART_1[32];
//#pragma udata

//#pragma udata USART_Buffer1
	char szUSART_Out[128];
//#pragma udata

//#pragma udata USART_Buffer2
	char szUSART_2[32];
//#pragma udata

// unsigned char nTICK;

//const rom unsigned char AccWrite = 0x0A, AccRead = 0x0B, Fifo = 0x0D;
//const rom unsigned char RTCWrite = 0x00, RTCRead = 0x80;
//
//const rom unsigned char RTCControl = 0b00000000, RTCClock = 0b00001000, RTCAlarm = 0b00010000, RTCTimer = 0b00011000;
//const rom unsigned char RTCTemp    = 0b00100000, RTCEE    = 0b00101000, RTCEECtrl = 0b00110000, RTCRAM = 0b00111000;

//short long lTid, lDatum;
//unsigned char nWeekDay;
//short long lGPSTid, lGPSDatum;
//short long lDefaultTid, lDefaultDatum;

//----------------------------------------------------------------------------
void SkrivBuffert(char *szUt, char nVal)
{
	int nLoop = 0;
	
	if (nVal == 1)
	{
		while (szUt[nLoop] != NULL)
		{
			putc1USART(szUt[nLoop]);
			while (Busy1USART() );
			Delay100TCYx(5);
			nLoop++;
		}
	}
	else	
	{
		while (szUt[nLoop] != NULL)
		{
			putc2USART(szUt[nLoop]);
			while (Busy2USART() );
			Delay100TCYx(5);
			nLoop++;
		}
	}	
}

// -----------------------------------------------------------------------------
void main(void)
{
    
    unsigned char nLoop, nTmp, nTemp, nTest, nLength;
    unsigned char FREQ_CTRL_INTE, FREQ_CTRL_FRAC_H, FREQ_CTRL_FRAC_M, FREQ_CTRL_FRAC_L;
    unsigned char FREQ_CTRL_INTE_433, FREQ_CTRL_FRAC_H_433, FREQ_CTRL_FRAC_M_433, FREQ_CTRL_FRAC_L_433;
	unsigned char  CTS_OK, szData[];
    unsigned char X_L, X_H, Y_L, Y_H, Z_L, Z_H;

	//signed char nOldX, nOldY, nOldZ;
    signed int xVal, yVal, zVal, xVal_100, yVal_100, zVal_100, i=0, nHi;
	//char lData;
    
	//FlagBits.bTimerIRQ = 0;  
	InitCPU();
    OSCILLATOR_Initialize();  // VET EJ OM DEN BEHÖVS
	
	//RTC_ENABLE = 0;
    
//	OpenTimer3(TIMER_INT_ON & T3_16BIT_RW & T3_SOURCE_INT & T3_PS_1_8);
//	WriteTimer3(0x7FFF);	// 1 sekund
//	WriteTimer3(0xBFFF);	// 500ms
	WriteTimer3(0);	
	
//	OpenTimer4(TIMER_INT_ON & T4_PS_1_16 & T4_POST_1_16);	// 6.5ms
//	WriteTimer4(0x00);
	
	nByte_1 = 0;
	nByte_2 = 0;
	nTimeOutUSART_1 = 0;
	nTimeOutUSART_2 = 0;

	// Ta bort eventuellt falskt IRQ 
	getc1USART();	
	getc2USART();	

	// Weak pull-up
	INTCON2bits.RBPU = 0;

	FlagBits.bReceived_1 = 0;
	nTimeOutUSART_1 = 0;
	nByte_1 = 0;
	szUSART_1[0] = '\0';

	FlagBits.bReceived_2 = 0;
	nTimeOutUSART_2 = 0;
	nByte_2 = 0;
	szUSART_2[0] = '\0';
    
    TRISCbits.TRISC7 = 1;		// RX
	TRISCbits.TRISC6 = 1;		// TX (0)
    
// 19200bps
	
    Open1USART( USART_TX_INT_OFF &
		USART_RX_INT_ON &
		USART_ASYNCH_MODE &
		USART_EIGHT_BIT &
		USART_CONT_RX &
		USART_BRGH_HIGH,
//		42 );				// HS      10MHz 
//		16 );				// INTOSC  4MHz
      12  );                 // INTIO67 1MHz    

	BAUDCON1bits.BRG16 = 1;

//	// 9600bps
//	Open2USART( USART_TX_INT_OFF &
//		USART_RX_INT_ON &
//		USART_ASYNCH_MODE &
//		USART_EIGHT_BIT &
//		USART_CONT_RX &
//		USART_BRGH_HIGH,
//		259);				// INTOSC  4MHz
////		103);				// HS     10MHz

	BAUDCON2bits.BRG16 = 1;

           
    LATAbits.LATA0 = 0; // 2.1 V 
    LATAbits.LATA2 = 1; // 3.3 V
    
	//Delay(100);
	
	//INTCONbits.GIE = 0;		// Global

// ************************************************************************************************** Startar programmet här
 
    GREEN_LED = 1; Delay(1000); // Tänd grön lampa
    GREEN_LED = 0;
    RED_LED = 1; Delay(1000); // Tänd röd lampa
    RED_LED = 0;
   //TestaVSEL();

// ----------------------------------------------------------------- Startar upp radion med denna kod

//        TCXO_EN = 1;        //Startar TCXO
//        
//        OpenSPI1(SPI_FOSC_4, MODE_00, SMPMID);     // Mode_00, SMPMID/END? 
//        
//        DoResetRadio();
//        
//        DoCheckCTSManyTimes1();
//        
//        DoStartRadio();
//        
//        DoCheckCTSManyTimes1(); 
//        
//        CloseSPI1();

//------------------------------------------------------------------ Starta upp accelerometern med denna kod
   OpenSPI1(SPI_FOSC_4, MODE_11, SMPMID);     

   nTmp = DoStartST_ACC();

    CloseSPI1();

    sprintf(szUSART_Out, (const rom far char *)"\x0C\r\n LIS2DW12 INITIERING:\r\n\r\n WHO_AM_I? \t0X%02X (0X44)\r\n\r\n", nTmp);
    SkrivBuffert(szUSART_Out, 1);
    Delay(10);

    //while (1){ 

        GREEN_LED = 1; Delay(10);
        GREEN_LED = 0;

    // ---------- Läs från Accelerometern ----------------------------------
    OpenSPI1(SPI_FOSC_4, MODE_11, SMPMID);   // 11, SMPMID 

    //nTmp = DoStartST_ACC();

    sprintf(szUSART_Out, (const rom far char *)"\x0C\r\n LIS2DW12 INITIERING:\r\n\r\n WHO_AM_I? \t0X%02X (0X44)\r\n\r\n", nTmp);
    SkrivBuffert(szUSART_Out, 1);

    ACC_ENABLE = 0;

    WriteSPI1(0xA8);        //(0xA8) Läs från adress 0x28 "OUT_X_L", data läses automatiskt ut i en linjär rörelse, bit 0 & 1 måste vara satta
    X_L = MyReadSPI();		// Data läses från den övre delen av X registrer
    X_H = MyReadSPI();      // Data läses från den nedre delen av X registrer
    Y_L = MyReadSPI();
    Y_H = MyReadSPI();
    Z_L = MyReadSPI();
    Z_H = MyReadSPI();

    ACC_ENABLE = 1;
    CloseSPI1();

    // Räkna ut accelerometerdatan, klumpa ihop de lägre bitarna med de högre
    xVal = AccDataCalc(X_L, X_H);
    yVal = AccDataCalc(Y_L, Y_H);
    zVal = AccDataCalc(Z_L, Z_H);

    // Dela värdet på 100 för att lättare analysera data
    xVal_100 = xVal / 100;
    yVal_100 = yVal / 100;
    zVal_100 = zVal / 100;

    sprintf(szUSART_Out, (const rom far char *)"\x0C\r\n X VAL: \t %d \r\n Y VAL: \t %d \r\n Z VAL: \t %d \r\n", xVal_100, yVal_100, zVal_100);
    SkrivBuffert(szUSART_Out, 1);
    Delay(1);

    for (nHi = 0; xVal_100 > nHi; nHi++)
    {
         GREEN_LED = 1; Delay(10);
         GREEN_LED = 0; 
    }

    Delay(100);

    for (nHi = 0; yVal_100 > nHi; nHi++)
    {
         RED_LED = 1; Delay(10);
         RED_LED = 0; 
    }

    Delay(100);

    // Z blinkar med den gröna lampan
    for (nHi = 0; zVal_100 > nHi; nHi++)
    {
         GREEN_LED = 1; Delay(10);
         GREEN_LED = 0; 
    }

// ---------------------------------------------------- Testar Hall Brytaren

    i = PORTBbits.RB5;
    if (i==0)
        {
        sprintf(szUSART_Out, (const rom far char *)"\x0C\r\n Hallswitchen är aktiv: \t %d \r\n\r\n", i);
        SkrivBuffert(szUSART_Out, 1);    
        }


// ------------------------------------------------------ Initierar radion        
    TCXO_EN = 1;        //Startar TCXO
    LATCbits.LATC1 = 1; // Start TCXO på första kortet

    filter = 1;
    InitTRXAndGotoSleep(); 

    // ------- Detta behövs ej, all initiering sker senare. --------- //

    //OpenSPI1(SPI_FOSC_4, MODE_00, SMPMID);
    //DoResetRadio();
    //DoCheckCTSManyTimes1();  
    //DoStartRadio();
    //DoCheckCTSManyTimes1(); 
    //CloseSPI1();

    //const unsigned char FREQ_CTRL_INTE = 0x04;

    // Ansätt variablerna redan i koden, dessa skall senare sättas via datorn direkt
//        FREQ_CTRL_INTE = 0x41;
//        FREQ_CTRL_FRAC_H = 0x0C;    // hastigheten skall vara 433.0515 
//        FREQ_CTRL_FRAC_M = 0xFC;
//        FREQ_CTRL_FRAC_L = 0x88;


    //-----------------------------------------------
    FREQ_CTRL_INTE = 0x44;          // hastigheten skall vara 151.123
    FREQ_CTRL_FRAC_H = 0x0D;    
    FREQ_CTRL_FRAC_M = 0xFE;
    FREQ_CTRL_FRAC_L = 0x1C;
    // ------------------------------------------------
    FREQ_CTRL_INTE_433 = 0x41;          // hastigheten skall vara 433.0515
    FREQ_CTRL_FRAC_H_433 = 0x0C;    
    FREQ_CTRL_FRAC_M_433 = 0xFC;
    FREQ_CTRL_FRAC_L_433 = 0x88;
    // ------------------------------------------------

    // Skriver in värdena för hastigheten 151.123 till EEProm
    Write2EE(FREQ_CTRL_INTE, 0x0000);       // 0
    Write2EE(FREQ_CTRL_FRAC_H, 0x0001);     // 1
    Write2EE(FREQ_CTRL_FRAC_M, 0x0002);     // 2
    Write2EE(FREQ_CTRL_FRAC_L, 0x0003);     // 3

    // Skriver in värdena för hastigheten 433.0515 till EEProm
    Write2EE(FREQ_CTRL_INTE_433, 0x0004);   // 4
    Write2EE(FREQ_CTRL_FRAC_H_433, 0x0005); // 5
    Write2EE(FREQ_CTRL_FRAC_M_433, 0x0006); // 6
    Write2EE(FREQ_CTRL_FRAC_L_433, 0x0007); // 7 


    // ----------------------------------------------------  Läs från radion

    OpenSPI1(SPI_FOSC_4, MODE_00, SMPMID);

    TRX_EN = 0;

    DoCheckCTSManyTimes1();

    ToggleRadio();

    WriteSPI1(0x01);

    ToggleRadio();

    nTmp = DoCheckCTSManyTimes1();

    // Hämtar PART_INFO
    if (nTmp == 0xFF)               // Om CTS är hög är allting rätt
    {
        nLoop = 0;                  
        while (nLoop < 4)
        {
            szData[nLoop] = MyReadSPI();
            nLoop++;
        }

        sprintf(szUSART_Out, (const rom far char *)"\x0C\r\n PART_ID_RADIO: - %02X%02X - \r\n\r\n", szData[1], szData[2]);
        SkrivBuffert(szUSART_Out, 1);

    }

    TRX_EN = 1;

    Delay(1);
    CloseSPI1(); 
         
        
    while(1){

        filter  = 0;    // UHF GRÖN
        DoInitBeacon();
        GreenLedPulse();
        Delay(1000);
        GreenLedPulse();
        Delay(1000);

        filter = 1;     // VHF RÖD
        DoInitBeacon();
        RedLedPulse();
        Delay(1000);
        RedLedPulse();
        Delay(1000);
        
        sprintf(szUSART_Out, (const rom far char *)"\x0C\r\n Filtervärde: - %d - \r\n\r\n", filter);
        SkrivBuffert(szUSART_Out, 1);

    }
    
    while(0)
    {
        
    // Kod till I2C accelerometern:
    SSP2ADD = 0x18; // Setting BoadRate
    
    //RTC_ENABLE = 1;     // För att se på skåpet
    
    OpenI2C2(MASTER, SLEW_ON); 
    
    StartI2C2();        // Start  kommando

    WriteI2C2(0x64); //SAD + W (D6) // 0110 010 (R/W) 
    
    AckI2C2();   // Get acknowledgement
    Blink();
    WriteI2C2(0x22); // Adress 0x0f (Who_AM_I), CTRL_REG_1 
    
    AckI2C2();   // Get Akcnowledgement
    
    RestartI2C2(); // Repeted Start
    
    WriteI2C2(0xD4); //SAD + R (D7)
    
    AckI2C2();   // Get acknowledgement
    
    WriteI2C2(0x81); // SW_RESET och BOOT
    
    AckI2C2();
    
    StopI2C2();
    
    CloseI2C2();

    // ---- KÖR IGEN -----------------------------------------------------------
    
    OpenI2C(MASTER, SLEW_ON); 
    
    StartI2C();        // Start  kommando

    IdleI2C();
    
    nTmp = WriteI2C(0xD4); //SAD + W (D6)
       
    IdleI2C();
    
    AckI2C();   // Get acknowledgement
    
    IdleI2C();
    
    nTmp = WriteI2C(0x22); // Read from adress 0x0f (Who_AM_I)

    IdleI2C();
    
    AckI2C();   // Get Akcnowledgement
    
    IdleI2C();
    
    RestartI2C(); // Repeted Start

    IdleI2C();
    
    nTmp = WriteI2C(0xD5); //SAD + R (D7)

    IdleI2C();
    
    AckI2C();   // Get acknowledgement
    
    IdleI2C();
    
    nTmp = ReadI2C();

    IdleI2C();
    
    NotAckI2C();
    
    StopI2C();
    
    CloseI2C();
    
    //RTC_ENABLE = 0;
    
	Blink();
   
    }  
}	
