Jurriz/VHF-Unit/(commit log)

2018-02-26 Stoppade in gamla rapporten
    [FMEA.xlsx]
2018-02-27 Stoppade in fler filer
    [Nätlista TXV-11 rev-01.xlsx]
2018-03-08 Kod som kan mäta accelerometerdata
2018-03-16 Inlämning fredag
    Lite allt möjligt, har skapat nätlista och tidsplan. Skrivit småsaker på rapporten
    [Nätlista TXV-11 rev-01.xlsx, Nätlista min version.xlsx, Tidsplanering.xlsx]
2018-03-20 Lade till massor
    [Nätlista min version.xlsx, Tidsplanering.xlsx]
2018-03-26 SI4463 + I2C kod
    Lade till massa filer från Hans Erik som handlade om radion. Har även skrivit massa kod till att prata I2C. Kommunikation fungerar nu med både radion och Acc med SPI.
    [Nätlista min version.xlsx, Tidsplanering.xlsx]
2018-04-06 Fixat mest PCB saker
    [Nätlista TXV-11 rev-01.xlsx, Radio Module scheme.SchDoc, Scheme VHF-Unit.SchDoc, VHF-Unit rev1.PrjPcb]
2018-04-09 saker allt möljligt
    [Tidsplanering.xlsx]
2018-04-20 massa saker, Kortet klart för test
    [DESIGN1.DSN, Design1.opj, Nätlista TXV-11 rev-01.xlsx, Nätlista min version.xlsx, Sheet1.SchDoc, Simulering.PrjPcb, Simulering.dsn, Simulering.opj]
2018-04-23 Allt möjligt
    [Scheme VHF-Unit.SchDoc]
2018-06-05 RadioKod, fått av HE + Simuleringar filter
    [Simulering.dsn]
2018-06-19 Lade in massa blandat från jobbdatorn
    [FMEA.xlsx, Simulering.dsn, Simulering.opj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]
2018-07-05 Skickade med allt från jobbet innan semestern
    [Simulering.dsn, Simulering.opj]
